medpar/TP1/Planificacion/Words/G1_PLANIFICACIÓN_ SEGUIMIENTO_CALIDAD.docx

# Plan de Trabajo del G1 TP1: Sistemas Electrónicos

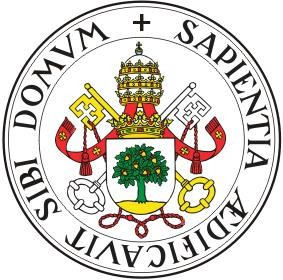
[picture p5: figure]

ESCUELA TÉCNICA SUPERIOR DE INGENIEROS DE TELECOMUNICACIÓN

UNIVERSIDAD DE VALLADOLID MÁSTER EN INGENIERÍA DE TELECOMUNICACIÓN TALLER DE PROYECTOS 1: SISTEMAS ELECTRÓNICOS

BARRIGON GOMEZ, MIGUEL MEDRANO PAREDES, MARIO RUIZ DE LAS HERAS, CLARA SANCHEZ VALENCIA, VICTOR

Semana | Actividad | Horas
1 | Especificación del proyecto Definición de objetivos | 4
2 | Especificación del proyecto Estudio sistema | 1
3 | Diseño electrónico y captura esquemática Búsqueda de componentes Posicionado componentes Creación de nuevos componentes Documentación esquemático. Control de cambios Análisis consumo eléctrico Análisis disipación de potencia Rutado de conexiones Generación de listado de materiales (BOM) | 7
4 | Diseño electrónico y captura esquemática Búsqueda de componentes Posicionado componentes Creación de nuevos componentes Documentación esquemático. Control de cambios Análisis consumo eléctrico Análisis disipación de potencia Rutado de conexiones Generación de listado de materiales (BOM) | 9,5
5 | Diseño de la placa de circuito impreso Creación de huellas de nuevos componentes Posicionado de componentes Definición de borde y zonas de conectores Rutado de conexiones Planos de disipación térmica Planos de masa y otros Documentación: serigrafía. Control de cambios Documentación: acotaciones geométricas Generación de ficheros para el fabricante (gerber) | 7,5
6 | Diseño de la placa de circuito impreso Creación de huellas de nuevos componentes Posicionado de componentes Definición de borde y zonas de conectores Rutado de conexiones Planos de disipación térmica Planos de masa y otros Documentación: serigrafía. Control de cambios Documentación: acotaciones geométricas Generación de ficheros para el fabricante (gerber) | 4
7 | Fabricación de la placa de circuito impreso Envío al fabricante Recepción y revisión Montaje de componentes | 4
8 | Fabricación de la placa de circuito impreso Envío al fabricante Recepción y revisión Montaje de componentes | 2

9 | Realización Firmware (uC/FPGA). Simulación y depuración Control de elementos hardware: drivers Verificación Programa principal. Especificaciones Documentación firmware. Control de cambios | 9
10 | Realización Firmware (uC/FPGA). Simulación y depuración Control de elementos hardware: drivers Verificación Programa principal. Especificaciones Documentación firmware. Control de cambios | 4
11 | Verificación hardware Verificación inicial Verificación firmware Resolución de problemas Análisis de prestaciones Montaje final. Piezas mecánicas | 4
12 | Verificación hardware Verificación inicial Verificación firmware Resolución de problemas Análisis de prestaciones Montaje final. Piezas mecánicas | 4
13 | | 7
14 | | 18
15 | Documentación Realización informe
| TOTAL

Diario

Semana 15/9-19/9

(Planificación: Definición de objetivos)

Durante esta semana se ha iniciado la asignatura de TP1-SE el martes 16 con una clase de 2h en la que se ha explicado la idea del proyecto, los contenidos de la asignatura y la forma de trabajo, además de todas las herramientas que se van a emplear. En la segunda sesión del día 19 de septiembre (1h) se ha terminado la introducción al proyecto con diferentes métodos de gestión de este. En esta sesión se han establecido los grupos de trabajo y se ha comenzado con la estimación temporal del proyecto con el método Gantt que se adjunta (1h).

Semana 22/9-26/9

(Planificación: Especificaciones del sistema)

El martes tuvimos 1h de clase donde conocimos las especificaciones hardware y como usar proteus, además de una hora donde Mario y Miguel empezaron con los diseños de las PBC’s y Victor y Clara terminaron el diagrama Gantt (1h). El miércoles por la tarde Miguel dedicó tiempo extra en la realización de los esquemáticos del PCB2 (2h). En la clase del viernes continuamos con el desarrollo de los diseños de los esquemáticos de las PBC’s (2.5h). En esta sesión se finalizaron los esquemáticos de las PCB1, PCB2 y PCB3, desarrollados por Mario, Miguel y Victor respectivamente. Clara comenzó el desarrollo de los esquemáticos correspondientes al PBC0.

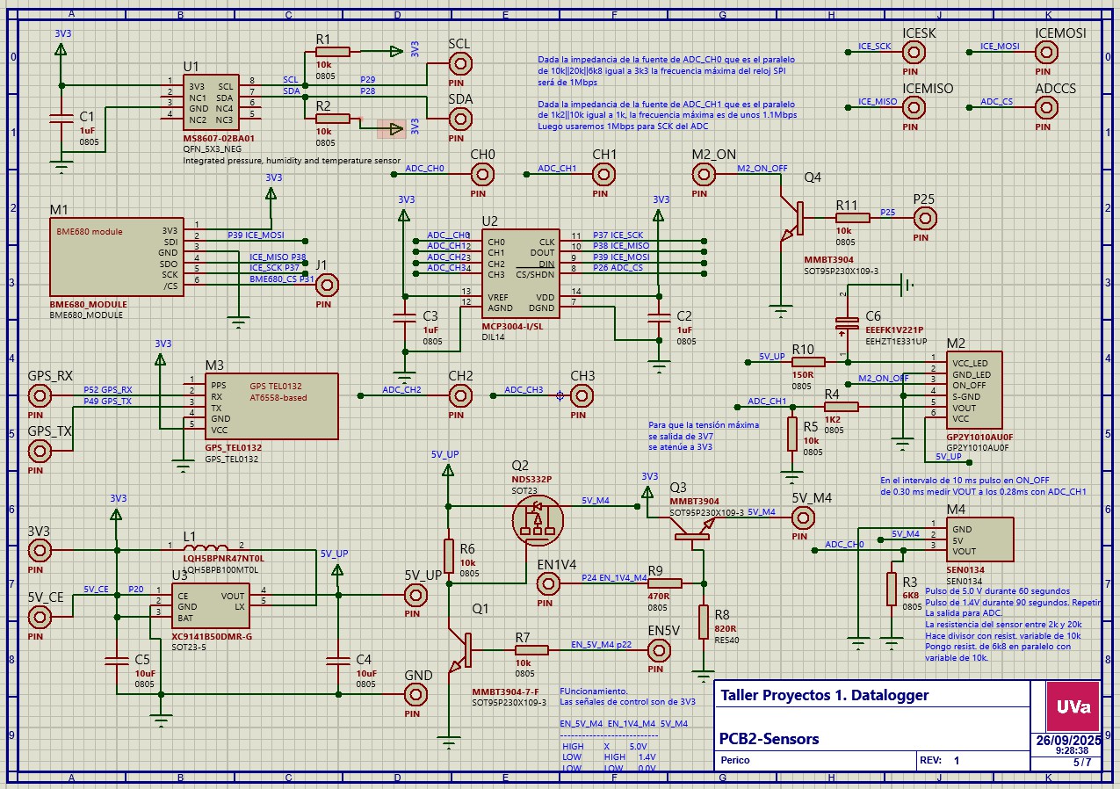
[picture p6: figure]

Figura 1. PCB2 Hoja raíz 1

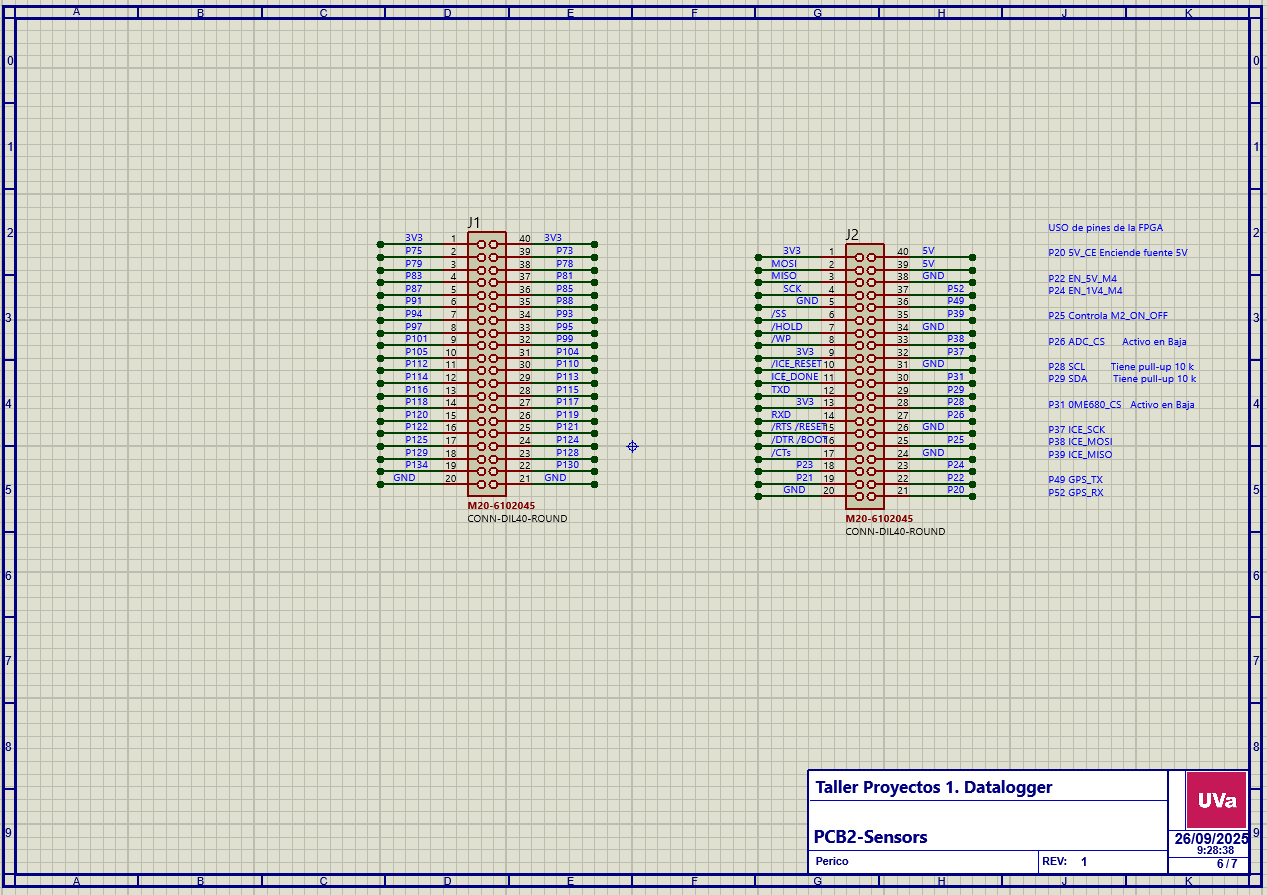
[picture p7: figure]

Figura 2. PCB2 Hoja raíz 2

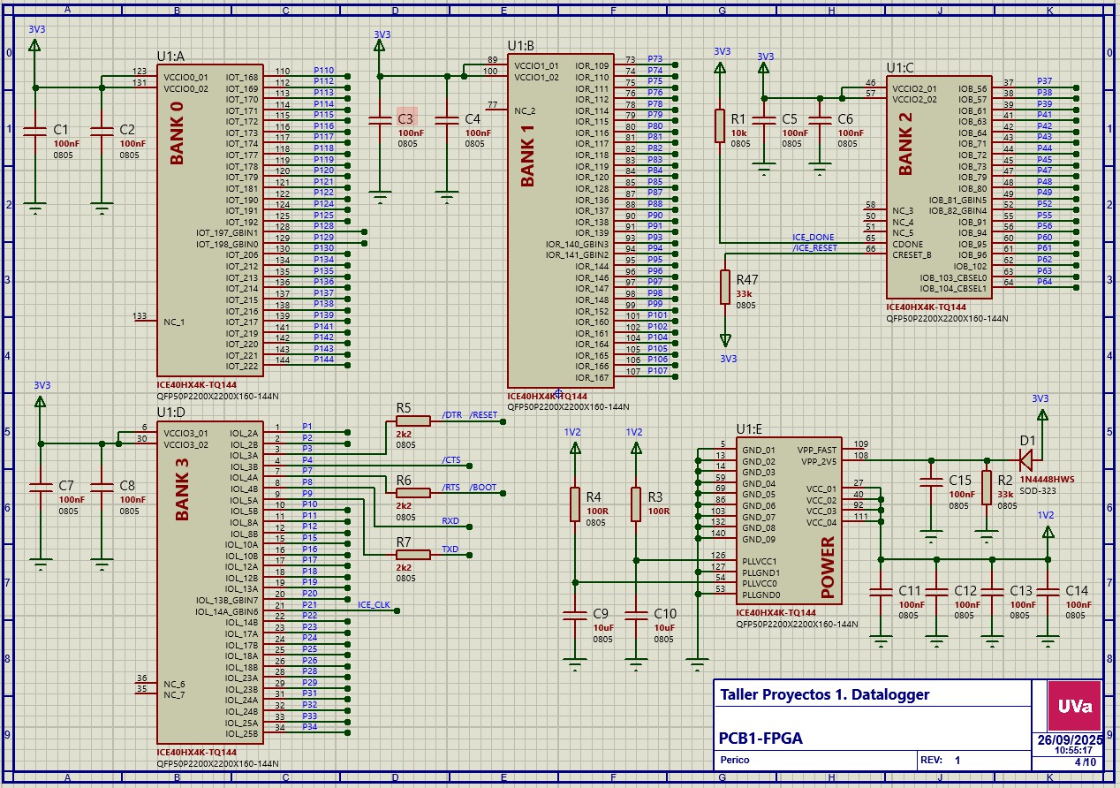
[picture p8: figure]

Figura 3. PCB1 Hoja raíz 1

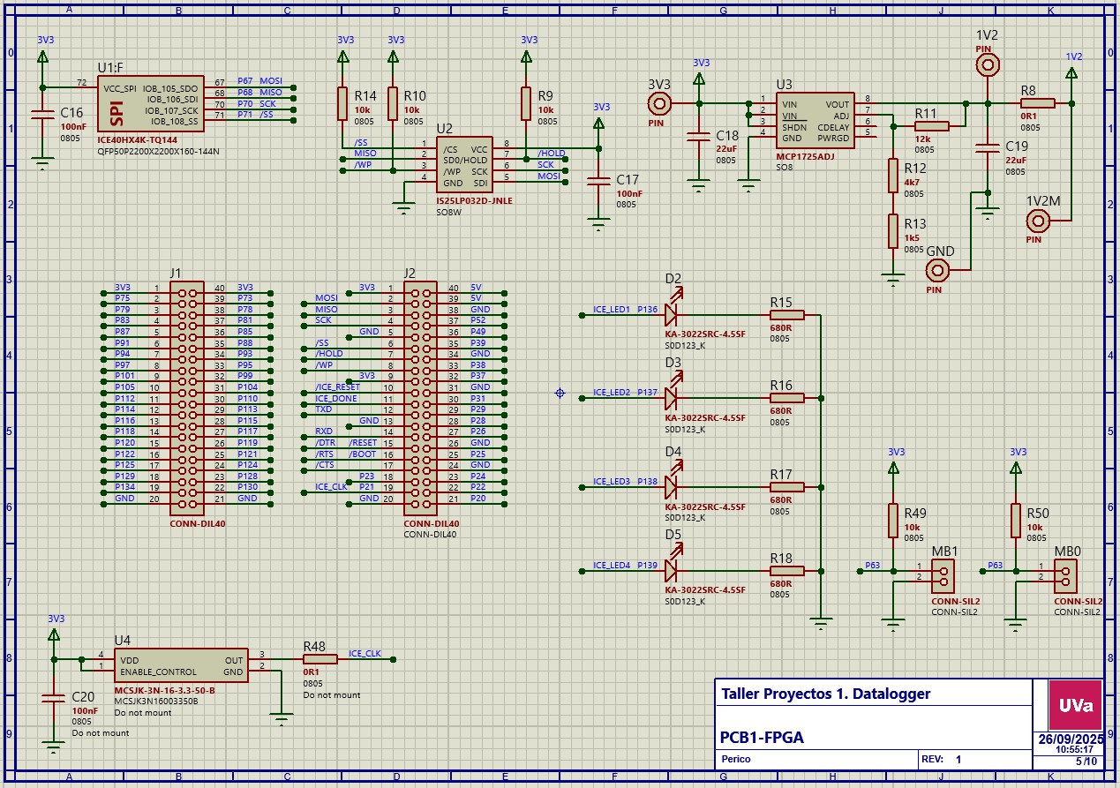
[picture p9: figure]

Figura 4. PCB1 Hoja raíz 2

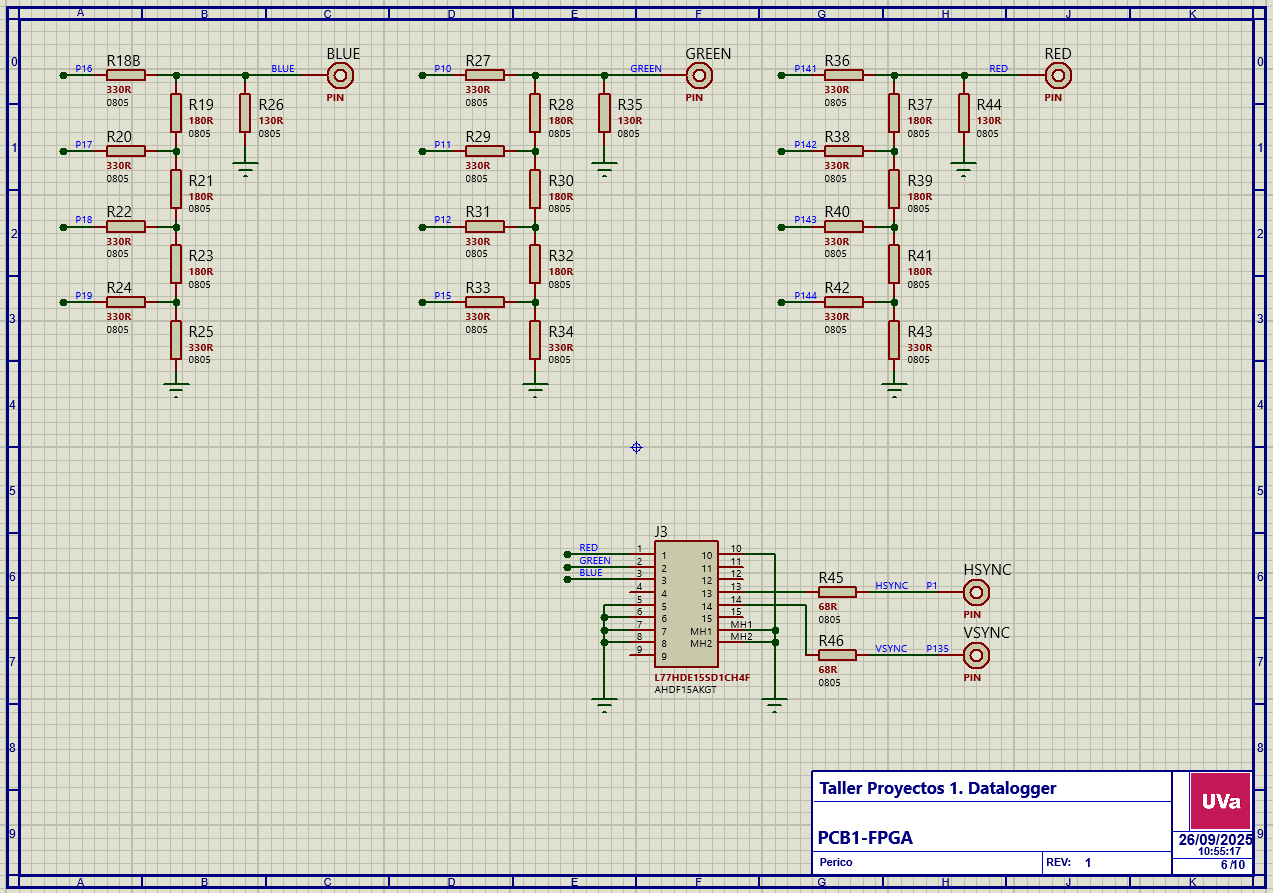
[picture p10: figure]

Figura 5. PCB1 Hoja raíz 3

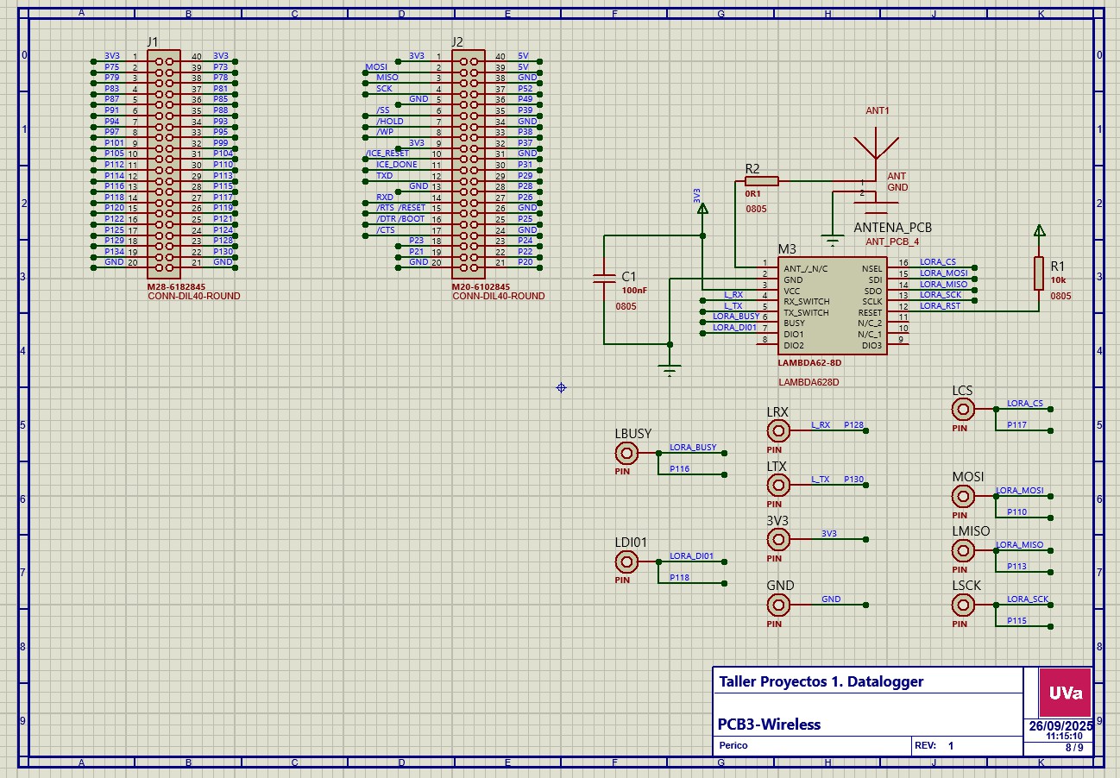
[picture p11: figure]

Figura 5. PCB1 Hoja raíz 3

Semana 29/9-3/10

(Planificación: Cálculo de costes y diseño de las PCBs)

En la sesión del martes se han realizado labores de actualización y refinado de los esquemáticos. Mario y Miguel comenzaron con la especificación de las PCBs mientras que Víctor y Clara se encargaban de comenzar con las hojas de coste y actualización de los diagramas Gant(1h). Clara dedico tiempo el jueves por la tarde para crear el logo y pensar en un nombre para nuestro grupo (2h).

En la sesión del viernes se continuo con las labores empezadas el martes dejando prácticamente acabadas las PCBs(dos de ellas no se van a poder mostrar por problemas para poder acceder a ellas al no haberse guardado correctamente) (2h).

Los esquemáticos se van a guardar en el Anexo 1 para así aligerar el peso de este archivo, y lo mismo se va a hacer con las PCBs en el Anexo 2. Se han introducido las imágenes actuales, cuando se realicen cambios las imágenes serán actualizadas.

Durante el fin de semana Víctor estuvo corrigiendo algunos de los comentarios del profesor durante la sesión. En concreto lo relativo a los ficheros BOM (que se encuentra en la carpeta BOM), además añadió el fichero final donde se detallará el proyecto en su conjunto, (1,5h).

Semana 06/9-12/10

(Planificación: análisis del consumo eléctrico)

El lunes tuvimos de nuevo una sesión de laboratorio, donde se enseñó como crear las huellas de los componentes y analizar el consumo eléctrico (1H). Además, continuamos realizando las huellas que se nos habían extraviado, actualizando el diagrama de Gantt y terminando con el Bill of Material (1 H).

Víctor actualizó el esquemático de la PCB3 debido a que íbamos a implementar una nueva antena con posibilidad de adaptación de impedancias con una red en forma de PI. Además, actualizó el BOM de la PCB3 con los nuevos componentes (0,5H).

El martes, Miguel y Mario continuaron con las PCBs. Se diseñaron y crearon las huellas faltantes y se finalizó el posicionamiento de todas las huellas para las cuatro placas de circuito impreso. Se diseñó la antena y se realizaron los cambios correspondientes en su esquemático. Víctor y Clara continuaron con la planificación, la documentación, el BOM y comenzaron a elaborar el análisis térmico y eléctrico.

Semana 13/10-19/10

(Planificación: análisis del consumo eléctrico)

El lunes tuvimos sesión de laboratorio, donde la primera sesión estuvimos aprendiendo sobre la PCB2 de sensores, su funcionamiento general, patillaje, consumos, o señales de calibración (1h). En la segunda parte de la sesión, Mario y Miguel finalizaron con las PCB que presentaron problemas anteriormente, mientras Víctor y Clara estuvieron con el análisis eléctrico de las PCB 0 y 1, además de con la actualización de la documentación, planificación y control de cambios (1H)

El miércoles, Miguel, finalizó las PCB’s 2 y 3, además de hacer el rutado de conexiones de estas PCB (2h)

Durante la sesión del viernes en el laboratorio se nos indicó cambios que debíamos hacer sobre los esquemáticos y las PCB, y nos pusimos a realizar estos cambios. Actualizamos la documentación, se finalizaron las PCBs 0 y 1 y sus rutados de conexiones. También continuamos con el análisis eléctrico. (2h)

El domingo Víctor finalizó el análisis eléctrico de la PCB 1 Y 3 (1h).

Semana 20/10-26/10

(Planificación: análisis del consumo eléctrico)

El lunes Víctor comenzó a redactar el inicio de la sección de planificación (0,5 h).

El martes Víctor y Clara trabajaron en el análisis eléctrico y térmico de los componentes durante las 2 horas, finalizando el análisis eléctrico e iniciando el análisis térmico de la PCB 0. Mientras, Miguel trabajó en el modelado de la antena de la PCB3 mientras que Mario finalizaba el rutado de la PCB1. Además ambos corrigieron los errores señalados por el profesor, referentes al diseño de las PCBs.

El jueves Víctor finalizó la corrección de los ficheros BOM según las instrucciones del profesor (2h), pasando la información de los pdf a los BOM. Además Clara trabajó el análisis térmico de los componentes, finalizando el análisis térmico de las 4 PCBs (1h).

El viernes Miguel finalizó el modelado de la antena de la PCB3. Además Mario y Miguel finalizaron la elaboración de los ficheros gerber y en general de todos los ficheros asociados a la elaboración de los esquemáticos de las PCBs.

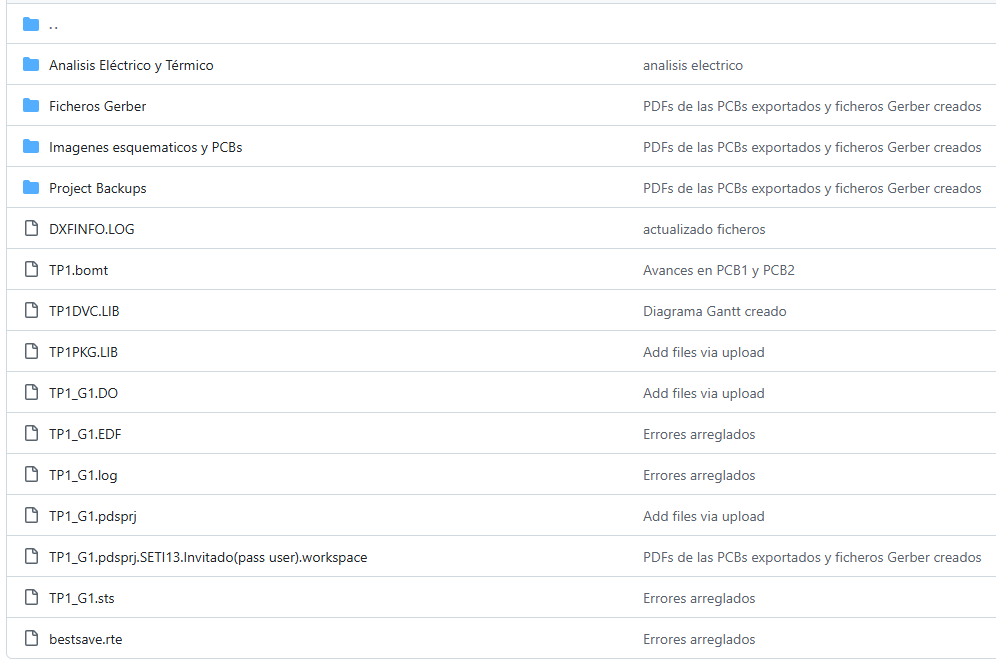
[picture p12: figure]

Semana 27/10-01/11

En esta semana se ha trabajado solo durante las dos horas de clase. Clara inicio el

trabajo de la presentación. Víctor empezó el informe final. Mario y Miguel corrigieron un

error de la PCB 3 relacionado con la antena, se "cosió" esa misma PCB y se corrigieron

los tamaños de las pistas de alimentación de las distintas PCBs

Semana 3/11-9/11

El martes, todos los integrantes del grupo realizaron la documentación y el estudio inicial para los contenidos de la presentación oral. El viernes, se prepararon las transparencias colaborativas y se incluyeron imágenes y diagramas representativos.

Además, se corrigieron errores menores en el diseño, se exportaron los PDFs con todas las PCBs, y se modeló la antena a fabricar en el programa de simulación electromagnética Ansys HFSS.

Semana 10/11-16/11

Durante esta semana todos los miembros del equipo tuvieron exámenes de otras asignaturas de manera que no tuvieron tiempo para continuar con las presentaciones o el envío al fabricante.

Semana 17/11-23/11

El martes antes de acudir a nuestra cita en el FABLAB, hicimos una revisión de la presentación que debíamos realizar para darnos cuenta que había algunas partes de esa presentación que no estaban completas. Llegada la hora fuimos a la visita de FABLAB donde nos enseñaron las herramientas de impresión 3D, escaner 3D, cortadora laser, … También asistimos a una lluvia de ideas para dar una solución con las herramientas vistas de un problema real. Expusimos ante los compañeros dichas ideas y regresamos al aula. (2h)

El viernes tuvimos una nueva sesión de laboratorio donde se revisaron las placas de antena para poder hacer el pedido a la fabricación. Se realizó el pedido a fabricación de la PCB3.

También se actualizó el diagrama Gannt,

(2h)

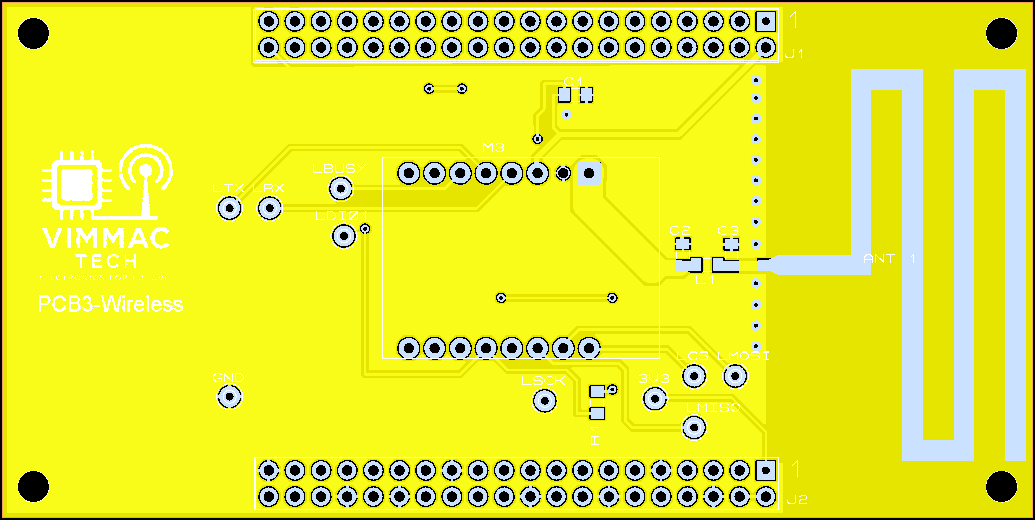
[picture p13: figure]
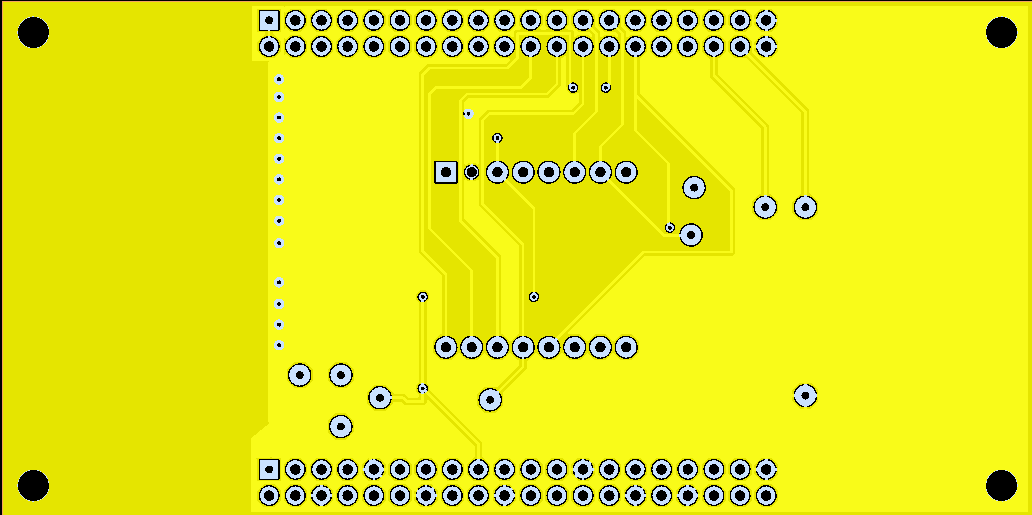
[picture p14: figure]

Semana 24/11-30/11

Durante la sesión del martes dedicamos la primera hora y media a grabar el vídeo de YouTube para el cual durante los días anteriores preparamos la presentación. Cada uno de nosotros presentó la parte que se había preparado tanto en inglés como en español. La última media hora nos sirvió para familiarizarnos con el laboratorio donde se montarán las PCB ya que el profesor nos dio una charla informativa sobre los protocolos de seguridad en este laboratorio.

Durante la sesión del viernes recibimos una charla introductoria por el profesor, en la que se nos explicaron los principios básicos para soldar y montar PCBs. Se comenzó el montaje y durante la última media hora Clara y Miguel procedieron con la ejecución de LarVa, con el objetivo de observar los datos enviados en el osciloscopio.

Como observaciones hay que aclarar que la PCB3 ya se ha fabricado y que a día 28 se encuentra en envío.

Semana 01/12-07/12

En esta semana ambas sesiones se han estructurado de manera similar, en ellas nos hemos dividido en grupos de dos, Víctor y Mario, Miguel y Clara. Durante las sesiones, Víctor y Mario se han dedicado a soldar componentes a una de las PCBs, mientras que Clara y Miguel se han dedicado a la parte relacionada con LarVa, modificando los direccionamientos de memoria y aumentado esta.

Semana 08/12-14/12

A lo largo de la sesión del martes, Víctor y Mario finalizaron el soldado y montaje de las dos placas de circuito impreso. Tras acabar, se comprobó el hardware para verificar que todos los componentes funcionasen correctamente. Miguel y Clara siguieron con la programación de LarVa.

Durante la sesión del viernes, Víctor y Mario continuaron con la memoria final, la documentación y la organización general del proyecto. Miguel y Clara continuaron con el desarrollo y el testeo del software.

Semana 15/12-21/12

En la sesión del martes Clara y Miguel han continuado con las UARTs y el SPI necesarias para la comunicación con los diferentes periféricos, han comprobado que funcionasen y estuvieran bien. Mario y Victor han continuado con la memoria y han empezado con la programación en C para poder leer los datos que manden cada sensor. (2h)

El jueves Miguel y Clara estuvieron en el laboratorio continuando con la programación de las UARTs y el PCIO (3h)

En la clase de jueves (muy navideña) hemos continuado arreglando los problemas de las UARTS, Victor por su parte ha estado con la decodificación de las señales GPS, y ya ha conseguido que funcione. (2h)

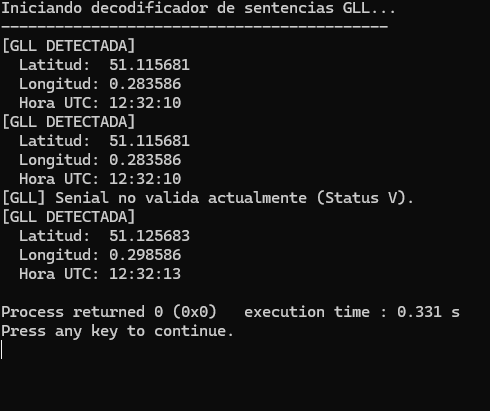
[picture p15: figure]

Semana 12/01-18/01

Durante la clase del lunes se trabajó repasando los avances realizados en el proyecto, así como repartiendo las tareas restantes entre los 4 miembros del grupo (2h). Además, por la tarde Mario trabajó en la programación de los sensores necesarios para el proyecto (3h).

Durante la tarde del martes Miguel y Clara estuvieron trabajando en la programación de las UARTS y SPI. Tras varias pruebas finalmente se detectó un fallo en una de las PCBs (4h).

El miércoles Miguel, Víctor y Clara trabajaron brevemente comprobando el funcionamiento del Datalogger una vez sustituidas las placas problemáticas por unas nuevas (3h).

El jueves Miguel trabajó por la tarde ajustando variables en el problema general y creando el script del módulo LoRa(4h).

Durante la clase del viernes continuamos con la integración de los sensores y el módulo LoRa en el programa(2h).

Plan de Trabajo del G1 de TP1: Sistemas Electrónicos
