medpar/TP1/Planificacion/Words/VIMMAC_TECH_G1_DOCUMENTACIÓN.docx

PROYECTO DATALOGGER


ESCUELA TÉCNICA SUPERIOR DE INGENIEROS DE TELECOMUNICACIÓN

UNIVERSIDAD DE VALLADOLID

MÁSTER EN INGENIERÍA DE TELECOMUNICACIÓN

TALLER DE PROYECTOS 1: SISTEMAS ELECTRÓNICOS

BARRIGON GOMEZ, MIGUEL

MEDRANO PAREDES, MARIO

RUIZ DE LAS HERAS, CLARA

SANCHEZ VALENCIA, VICTOR

RESUMEN

# 1. Introducción

# 2. Planificación

## 2.1 Diagramas de Gantt

# 3. Hardware

## 3.1 Esquemas Electrónicos

ANEXO 1

# ANEXO 1: ESQUEMATICOS

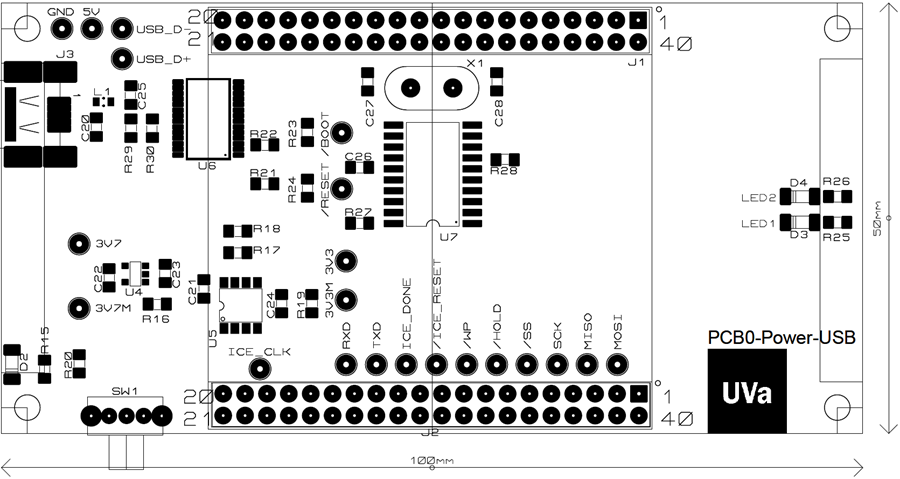
[picture p18: figure]

# ANEXO 2: PCB

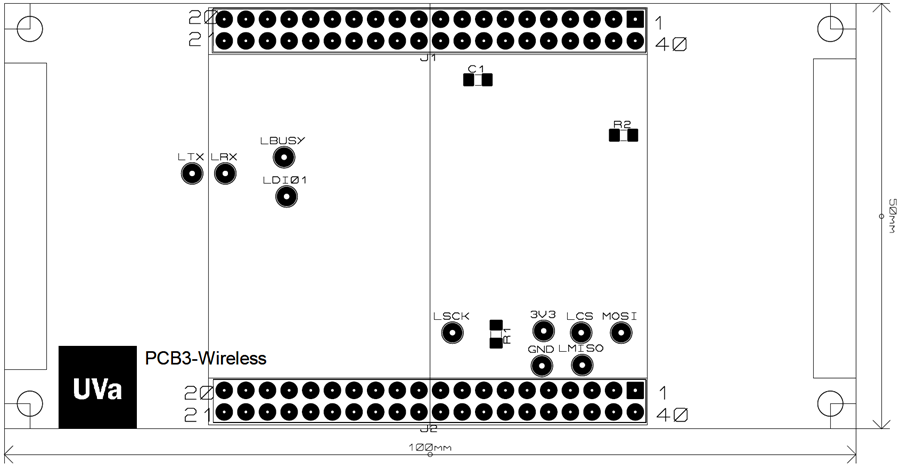
[picture p19: figure]

# ANEXO 3: Bill Of Materials

VIMMAC TECHProyecto Datalogger1
