medpar/TP1/Hardware/Analisis Eléctrico y Térmico/Analisiselectrico-C.xlsx

Sheet: TOTAL_V
ANALISIS ELECTRICO |  |  | ANALISIS TÉRMICO
P_3,3V | 4.5224743 | W | t_3,3V | 141.5148182 | ºc
P_5V | 0.10759 | W | t_5V | 1.73058 | ºc
P_2,6V | 0.052 | W | t_2,6V | 13 | ºc
P_3,7V | 0 | W | t_3,7V | 0 | ºc
P_1,2V | 2.52e-05 | W | t_1,2V | 0.00096516 | ºc
TOTAL | 4.6820895 | W | TOTAL | 156.2463633 | ºc

Sheet: PCB0.Alim_Prog_USB
Power Calculations |  |  |  |  | Thermal Analysis
Components | Conditions | Voltage (V) | Currents (µA) | Power (W) | Components | Conditions | Power | Max Power | Theta_jar(Cº/W) | Temperature (Cº)
MCP73831T-2QACI/OT | Charging | 5 | 1500 | 0.0075 | MCP73831T-2QACI/OT | Charging | 0.0075 |  | 230 | 1.725
 |  |  |  |  |  | 4-Layer JC51-7 Standard Board, Natural Convection |  |  |  | 0
MCP1725-ADJ E/SN | IL = 0 mA, VIN = Note 1 VOUT = 0.8V to 5.0V | 3.3 | 5000 | 0.85 | MCP1725-ADJ E/SN | IL = 0 mA, VIN = Note 1 VOUT = 0.8V to 5.0V | 0.85 |  | 163 | 138.55
CY765213-28PVXI | USB 2.0 FS, UART at 1-Mbps single channel, no GPIO switching at VCC = 5 V, VCCIO = 5 V | 5 | 18 | 9e-05 | CY765213-28PVXI | USB 2.0 FS, UART at 1-Mbps single channel, no GPIO switching at VCC = 5 V, VCCIO = 5 V | 9e-05 |  | 62 | 0.00558
LPC1112FD20/102 | Per supply pin | 3.3 | 3000 | 0.0099 | LPC1112FD20/102 | Per supply pin | 0.0099 |  | 115.2 | 1.14048
 |  | P_5V | 0.00759 | W |  |  |  | P_5V | 1.73058 | ºc
 |  | P_3,3V | 0.8599 | W |  |  |  | P_3,3V | 139.69048 | ºc
 |  | P_2,6V | 0 | W |  |  |  | P_2,6V | 0 | ºc
 |  | P_3,7V | 0 | W |  |  |  | P_3,7V | 0 | ºc
 |  | TOTAL | 0.86749 | W |  |  |  | TOTAL | 141.42106 | ºc
 |  |  | 867.49 | mW
Note 1: VIN ≥ 2.3V, VIN ≥ VOUT(MAX) + VDROPOUT(MAX), VIN ≥ 2.3V, VIN ≥ VOUT(MAX) + VDROPOUT(MAX)

Sheet: PCB1.FPGA
Power Calculations |  |  |  |  | Thermal Analysis
Components | Conditions | Voltage (V) | Currents (A) | Power (W) | Components | Conditions | Power | Max Power | Theta_jar(°C/W) | Temperature (Cº)
ICE40HX4K-TQ144 | standby power | 3.3 | 2.1e-05 | 6.93e-05 | ICE40HX4K-TQ144 | standby power | 6.93e-05 |  | 38.3 | 0.00265419
ICE40HX4K-TQ144 | power | 1.2 | 2.1e-05 | 2.52e-05 | ICE40HX4K-TQ144 | power | 2.52e-05 |  | 38.3 | 0.00096516
1N4448HSW-7-F |  | 3.3 | 1e-05 | 3.3e-05 | 1N4448HSW-7-F |  | 3.3e-05 |  | 222 | 0.007326
IS25LP032D-JNLE | FRD Quad at 133MHz | 3.3 | 0.017 | 0.0561 | IS25LP032D-JNLE | FRD Quad at 133MHz | 0.0561 |  |  | 0
MCP1725-ADJ E/SN | IL = 0 mA, VIN = Note 1, VOUT = 0.8V to 5.0V | 3.3 | 0.00022 | 0.000726 | MCP1725-ADJ E/SN | IL = 0 mA, VIN = Note 1, VOUT = 0.8V to 5.0V | 0.000726 |  | 163 | 0.118338
M20-6102045 |  | 0 | 0 | 0 | M20-6102045 |  | 0 |  |  | 0
109296002381906 |  | 0 | 0 | 0 | 109296002381906 |  | 0 |  |  | 0
MCSJK-3N-16.00-3.3-50-B | Supply Current | 3.3 | 0.015 | 0.0495 | MCSJK-3N-16.00-3.3-50-B | Supply Current | 0.0495 |  |  | 0
HSMS-C170 |  | 2.6 | 0.02 | 0.052 | HSMS-C170 |  | 0.052 |  | 250 | 13
L77HDE15SD1CH4F |  | 0 | 0 | 0 | L77HDE15SD1CH4F |  | 0
 | P_3,3V | 0.1064283 | W |  |  |  |  | P_5V | 0 | ºC
 | P_1,2V | 2.52e-05 | W |  |  |  |  | P_3,3V | 0.12831819 | ºC
 | P_2,6V | 0.052 | W |  |  |  |  | P_2,6V | 13 | ºC
 |  |  |  |  |  |  |  | P_3,7V | 0 | ºC
 | TOTAL | 0.1584535 | W |  |  |  |  | P_1,2V | 0.00096516 | ºC
 |  | 158.4535 | mW
 |  |  |  |  |  |  |  | TOTAL | 13.12928335 | ºC

Sheet: PCB2.Sensores
Power Calculations |  |  |  |  | Thermal Analysis
Components | Conditions | Voltage (V) | Currents (mA) | Power (W) | Components | Conditions | Power | Max Power | Theta_jar | Temperature (Cº)
TEL0132 |  | 3.3 | 25 | 0.0825 | TEL0132 |  | 0.0825
BME680 |  | 3.3 | 12 | 0.0396 | BME680 |  | 0.0396
MS860702BA01-50 | 25°C, VDD = 3V | 3.3 | 240 | 0.792 | MS860702BA01-50 | 25°C, VDD = 3V | 0.792 |  |  | 1.5 | temperature increase over humidity sensor
GP2Y1010AU0F |  | 5 | 20 | 0.1 | GP2Y1010AU0F |  | 0.1
SEN0134 |  | 5 |  | 0 | SEN0134 |  | 0
MCP3004-I/SL | VDD = VREF = 5V, DOUT unloaded VDD = VREF = 2.7V, DOUT unloaded | 3.3 | 0.55 | 0.001815 | MCP3004-I/SL | VDD = VREF = 5V, DOUT unloaded VDD = VREF = 2.7V, DOUT unloaded | 0.001815 |  | 108 | 0.19602
XC9141B50DMR-G |  | 3.3 | 800 | 2.64 | XC9141B50DMR-G |  | 2.64
 |  | P_3,3V | 3.555915 | W |  |  | P_5V | 0 | ºc
 |  | P_5V | 0.1 | W |  |  | P_3,3V | 1.69602 | ºc
 |  | P_2,6V | 0 | W |  |  | P_2,6V | 0 | ºc
 |  |  |  |  |  |  | P_3,7V | 0 | ºc
 |  | TOTAL | 3.655915 | W |  |  | P_1,2V | 0 | ºc
 |  |  | 3655.915 | mW
 |  |  |  |  |  |  | TOTAL | 1.69602 | ºc

Sheet: PCB3.Antena en PCB
Power Calculations |  |  |  |  |  | Thermal Analysis
Components | Conditions | Voltage (V) | Currents (µA) | Power (W) |  | Components | Conditions | Power | Max Power | Theta_jar | Temperature (Cº)
LAMBDA62-8D | Quiescent current | 3.3 | 7e-05 | 0.000231 |  | LAMBDA62-8D | Quiescent current | 0.000231
 |  |  | P_3,3V | 0.000231 | W
 |  |  | TOTAL | 0.000231 | W |  | P_3,3V | 0 | ºc
 |  |  |  | 0.231 | mW |  | TOTAL | 0 | ºc
