medpar/TP1/Planificacion/Words/gantt_final.png

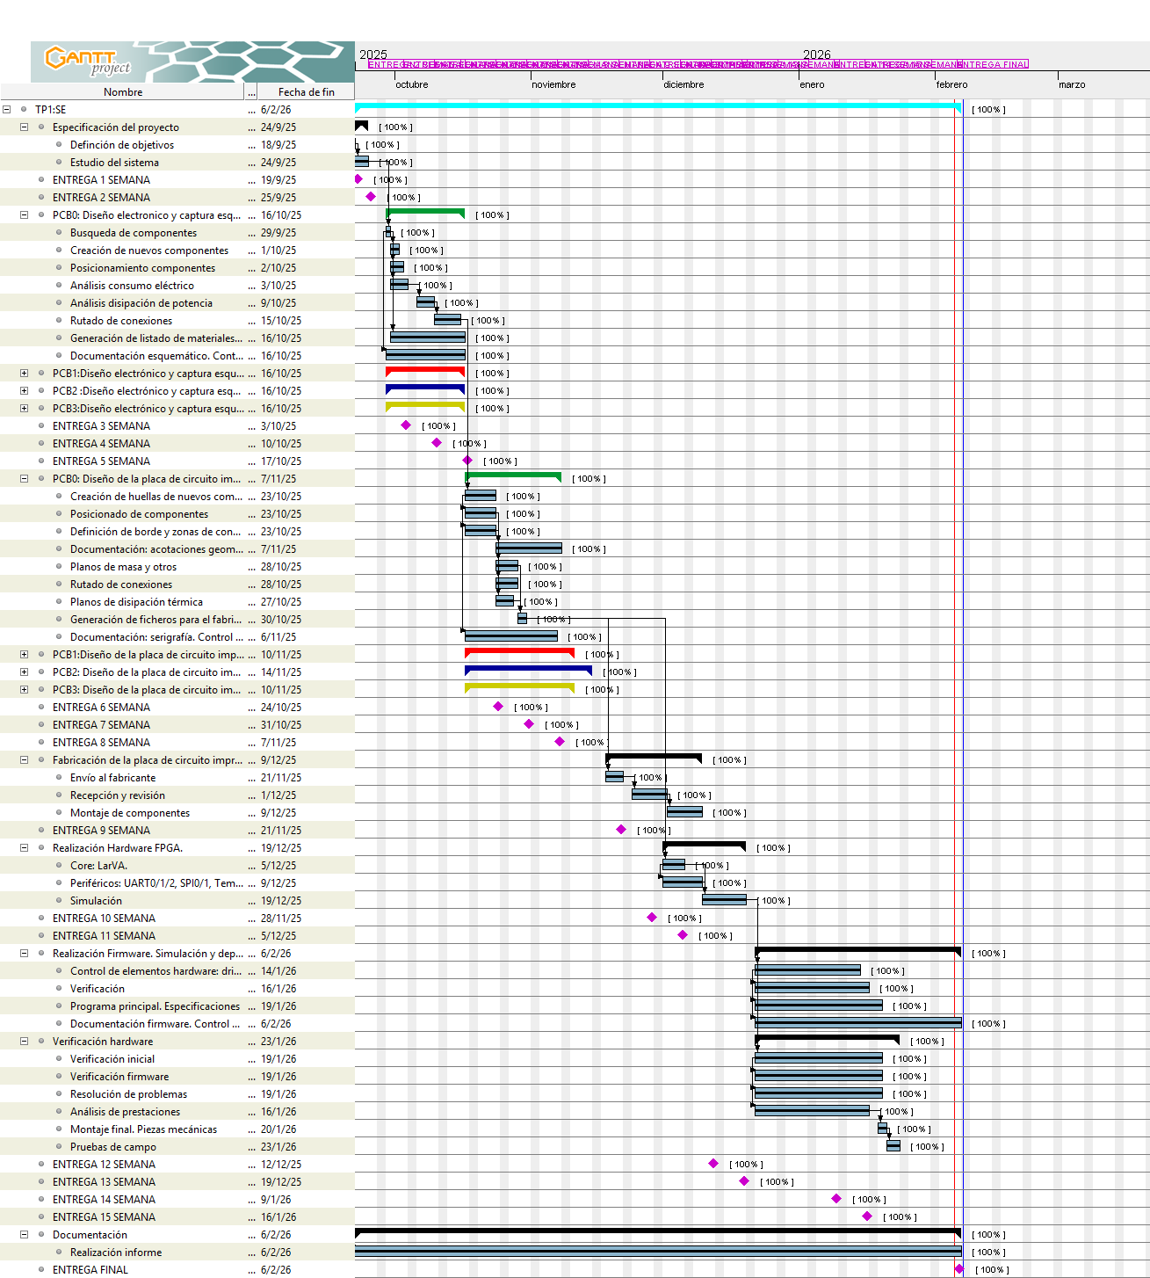
Planificacion/Words/gantt_final.png
