medpar/TP1/Planificacion/Words/TP1SEgantt.png

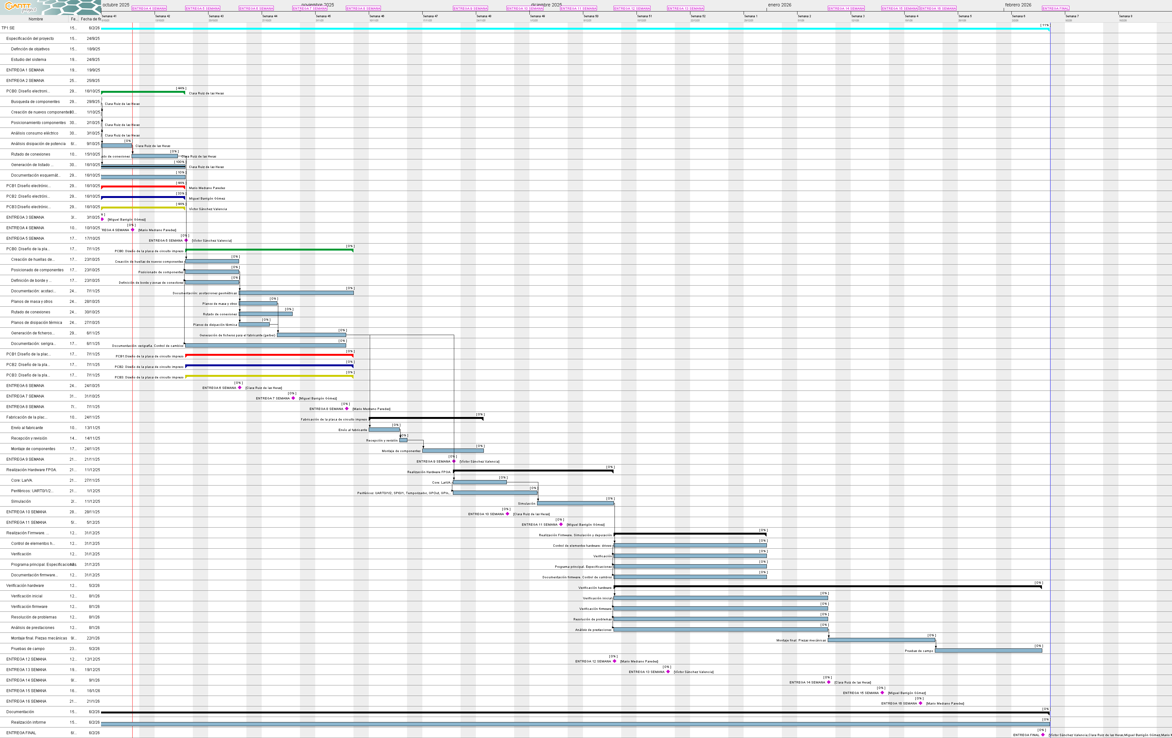
Planificacion/Words/TP1SEgantt.png
