medpar/TP1/Planificacion/Words/TP1SEPERT.png

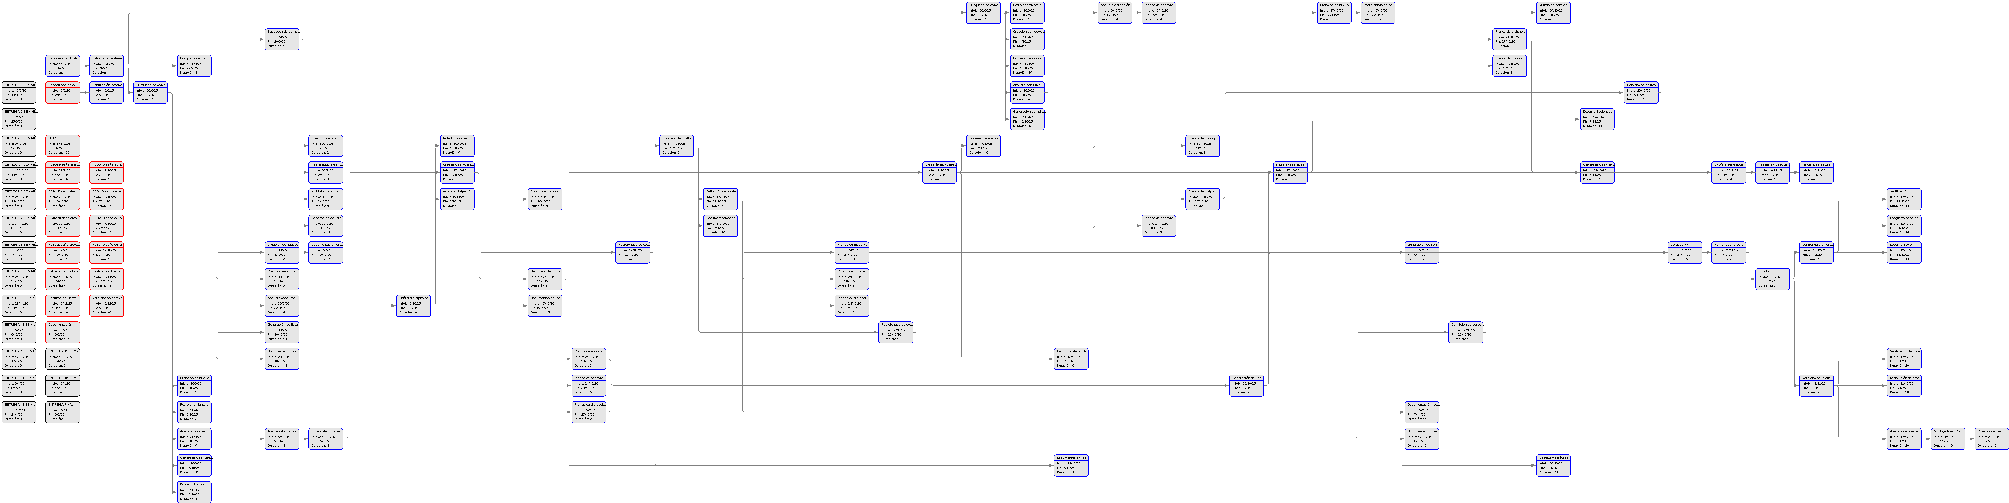
Planificacion/Words/TP1SEPERT.png
