medpar/TP1/Software/Captura de pantalla (2).png

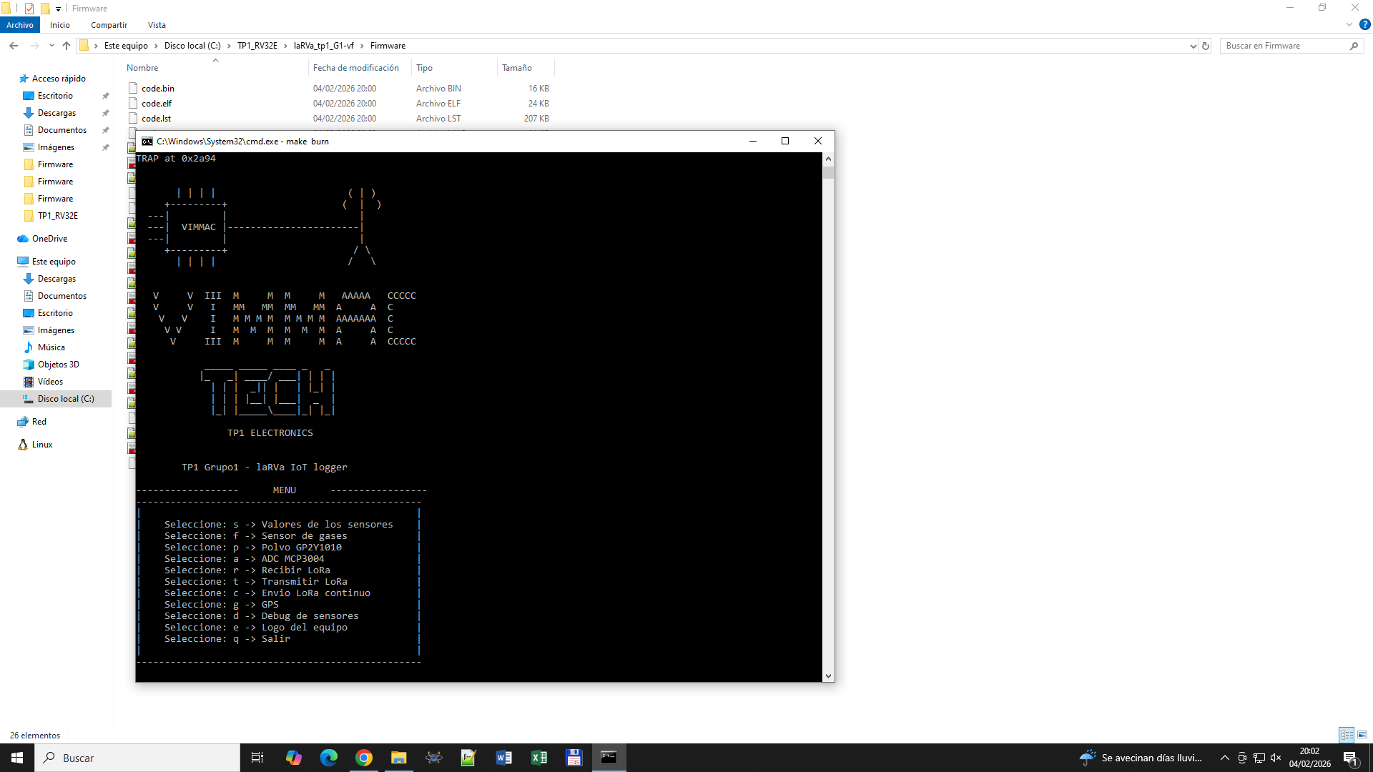
Software/Captura de pantalla (2).png
