medpar/TP1/Software/Captura de pantalla (8).png

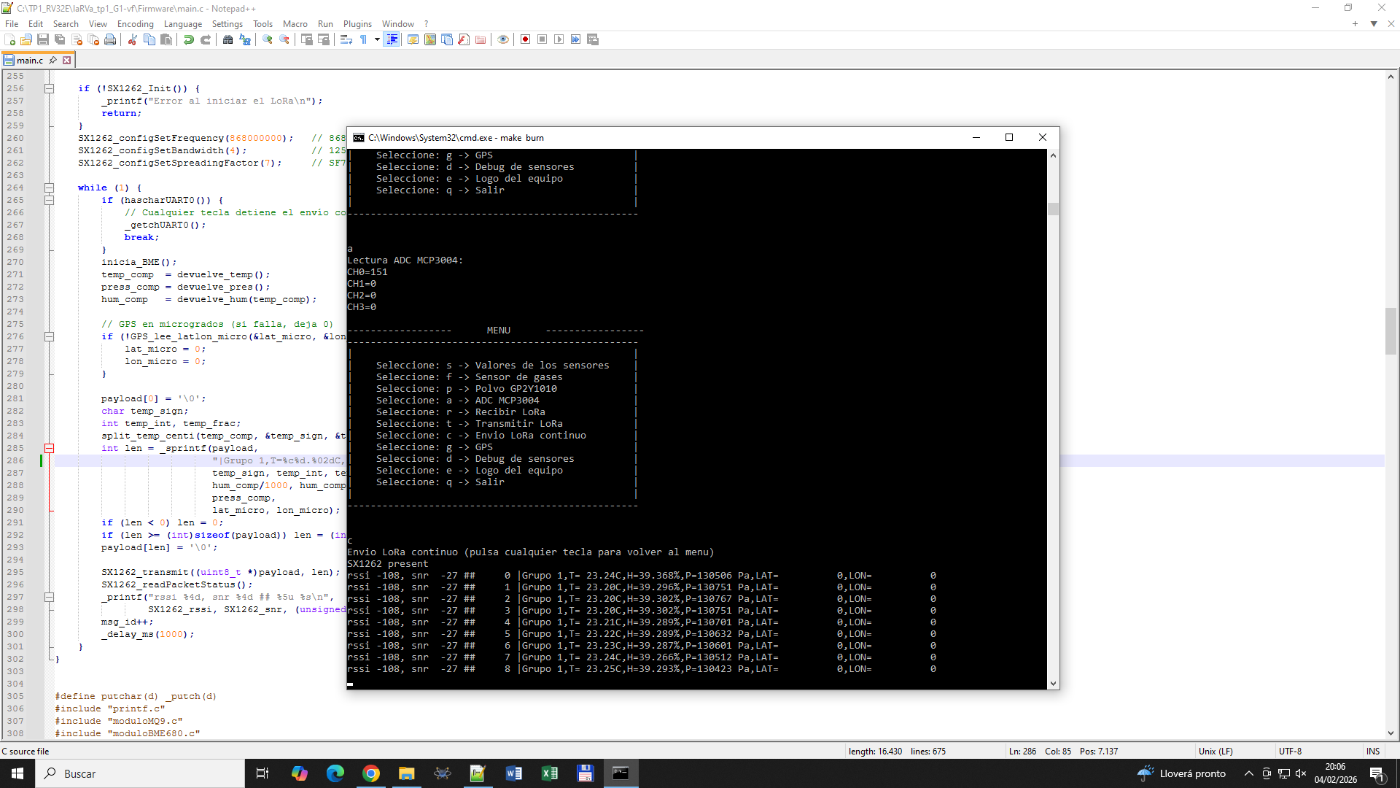
Software/Captura de pantalla (8).png
