medpar/TP1/Software/Captura de pantalla (9).png

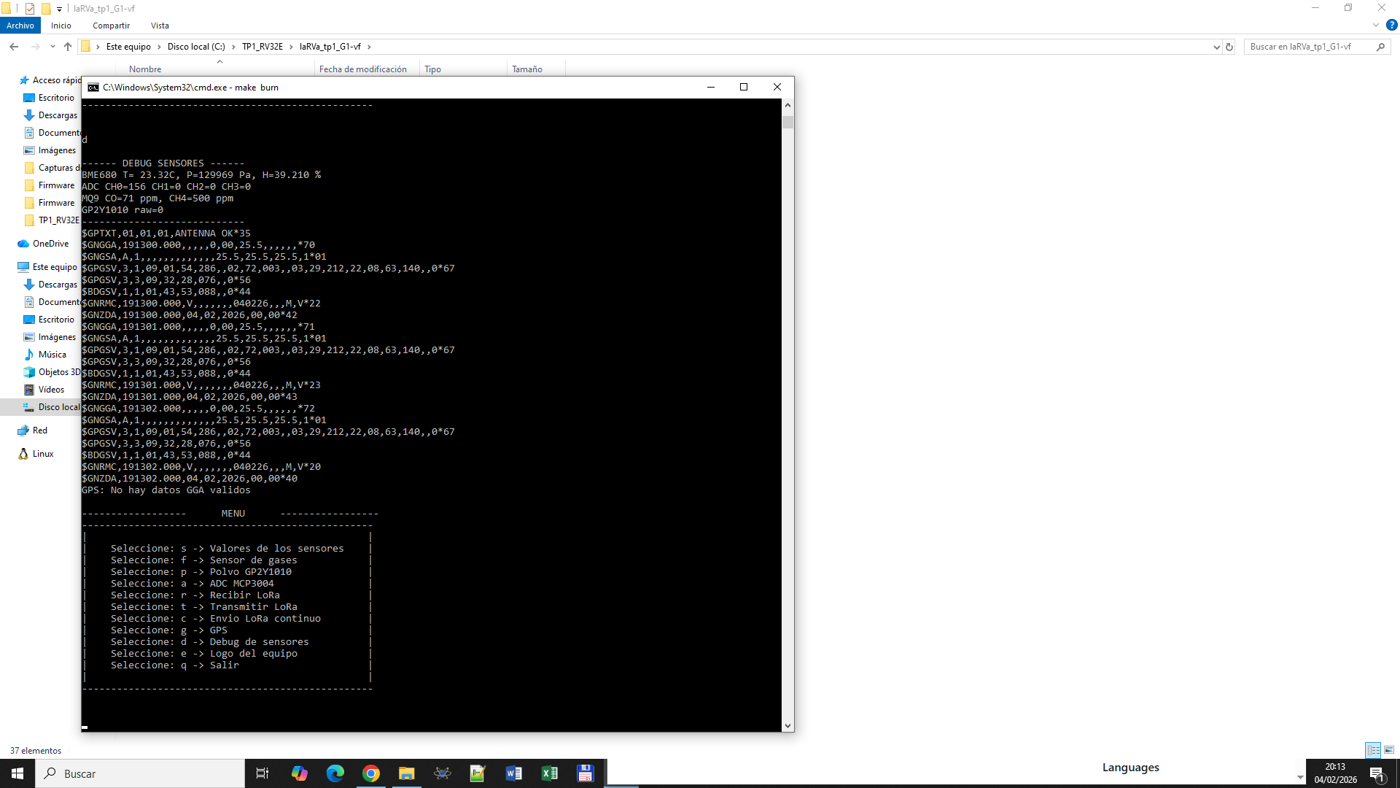
Software/Captura de pantalla (9).png
