medpar/TP1/Planificacion/BOM/BOM0.pdf

### Universidad de Valladolid Desarrollo Práctico de Sistemas Electrónicos

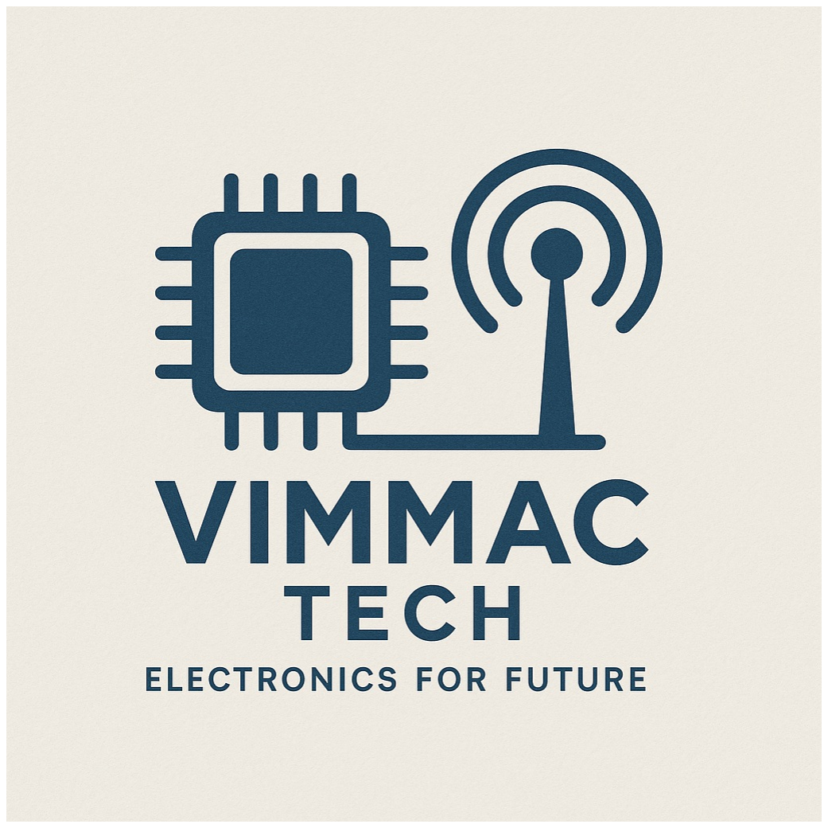
[picture p30: figure]

### Bill Of Materials for Taller Proyectos 1. Datalogger

Design Title | Taller Proyectos 1. Datalogger
Author | VIMMAC TECH
Document Number | 1
Revision | 3
Board | PCB0-Power-USB
Design Created | miércoles, 21 de septiembre de 2022
Design Last Modiied viernes, 24 de octubre de 2025 Total Parts In Design 61

Notes
Precios sin IVA (21%), VAT not added
No incluyen gastos de envio, shipping costs not included
Algunos valores corresponden con la compra de 10 uds o más, Some values correspond to the purchase of 10 units or more.

### 9 Capacitors

Quantity | References | Value | PCB Package | Farnell code
Cost
2 | C20,C26 | 100nF | 0805 | | 0,168€
4 | | C21,C22,C23,C24 | | 22uF | | 0805 | 0,29325€
1 | | C25 | | 10pF | | 0805 | 0,0255€
2 | | C27,C28 | | 18pF | | 0805 | 0,283€
Sub-totals: | 2,10€

### 16 Resistors

Quantity | References | Value | PCB Package | Farnell code
Cost
1 | R15 | 220R | 0805 | | 0,0216€
3 | | R16,R27,R28 | | 2k2 | | 0805 | 0,0173€
1 | | R17 | | 71K5 | | 0805 | 0,0364€
4 | | R18,R23,R24,R30 | | 10k | | 0805 | 0,175€
2 | R19,R20 | 0R1 | 0805 | | 0,0939€
2 | | R21,R22 | | 470R | | 0805 | 0,0407€
2 | R25,R26 | 680R | 0805 | | 0,033€
1 | | R29 | | 4K7 | | 0805 | 0,0381€
Sub-totals: | 1,18€

### 4 Integrated Circuits

Quantity | References | Value | PCB Package | Farnell code | Cost
1 | U4 | MCP73831T-2ACI/OT | SOT23-5 | 1332158 | 0,636€
1 | | U5 | | MCP1725-ADJ E/SN | | S08 | 1834878 | 0,655€
1 | U6 | CY7C65213-28PVXI | SSOP28 | 2767866 | 1,730€
1 | | U7 | | LPC1112FD20/102 | | SO20W | 2470837 | 2.56€
Sub-totals: | | | | | 5,58€

### 3 Diodes

Quantity | References | Value | PCB Package | Farnell code | Cost
2 | D2,D3 | HSMSC170 | SOD123_K | 5790839 | 0,179€

1 | D4 | KA-3022SGC-4.5SF | SOD123_K | 1142615 | 0,33€
Sub-totals: | | | | | 0,69€

### 29 Miscellaneous

Quantity | References | Value | PCB Package | Farnell code | Cost
21 | /BOOT,/HOLD,/ICE_RESET,/RESET,/SS,/WP,3V3,3V7, 3V3M,3V7M,5V,GND,ICE_CLK,ICE_DONE,MISO,MOSI, RXD,SCK,TXD,USB_D+,USB_D- | PIN | PIN | | 0€
1 | | BAT | | 530480310 | | 530480310 | 9732918 | 0,260€
1 | BAT5 | LP735977JH | NULL | 4551044 | 34,760€
2 | | J1,J2 | | 2214S-40SG-85 | | CONN-DIL40- | 2847248 | 1,86€
ROUND
1 | J3 | USB MINI B Molex 67503-1230 | MOLEX USB MINI B 67503-1230 | 2313554 | 1,140€
1 | | L1 | | MMZ1608B121C | | RESC1608X84 | 2800823 | 0,0484€
1 | | SW1 | | OS102011MA1QS1 | | OS102011MA1QS1 | 2435103 | 0,455€
1 | | X1 | | ABL-12.000MHZ-B2 | | HC-49S-TH | 2467707 | 0,235€
Sub-totals: | 40,62€
Totals: | 50,17€ viernes, 24 de octubre de 2025 0:42:28
