medpar/TP1/Planificacion/BOM/BOM1.pdf

### Universidad de Valladolid Desarrollo Práctico de Sistemas Electrónicos


### Bill Of Materials for Taller Proyectos 1. Datalogger

Design Title | Taller Proyectos 1. Datalogger
Author | VIMMAC TECH
Document Number | 1
Revision | 3
Board | PCB1-FPGA
Design Created | miércoles, 21 de septiembre de 2022
Design Last Modiied viernes, 24 de octubre de 2025 Total Parts In Design 94

Notes
Precios sin IVA (21%), VAT not added
No incluyen gastos de envio, shipping costs not included
Algunos valores corresponden con la compra de 10 uds o más, Some values correspond to the purchase of 10 units or more.

### 20 Capacitors

Quantity | References | Value | PCB Package | Farnell code
Cost
16 | C1,C2,C3,C4,C5,C6,C7,C8,C11,C12,C13, C14,C15,C16,C17,C20 | 100nF | 0805 | | 0,168€
2 | | C9,C10 | | 10uF | | 0805 | 0,0545 €
2 | | C18,C19 | | 22uF | | 0805 | 0,29325€
Sub-totals: | 3,38€

### 51 Resistors

Quantity | References | Value | PCB Package | Farnell code
Cost
6 | R1,R9,R10,R14,R49,R50 | 10k | 0805 | | 0,175€
2 | | R2,R47 | | 33k | | 0805 | 0,0564€
2 | R3,R4 | 100R | 0805 | | 0,0521€
3 | | R5,R6,R7 | | 2k2 | | 0805 | 0,0173€
2 | | R8,R48 | | 0R1 | | 0805 | 0,0939€
1 | | R11 | | 12k | | 0805 | 0,420€
1 | R12 | 4k7 | 0805 | | 0,0381€
1 | | R13 | | 1k5 | | 0805 | 0,420€
4 | R15,R16,R17,R18 | 680R | 0805 | | 0,033€
9 | | R19,R21,R23,R28,R30,R32,R37,R39,R41 | | 180R | | 0805 | 0,0753€
15 | R20,R22,R24,R25,R27,R29,R31,R33,R34, R36,R38,R40,R42,R43,R18B | 330R | 0805 | | 0,270€
3 | | R26,R35,R44 | | 130R | | 0805 | 0,0345€
2 | R45,R46 | 68R | 0805 | | 0,0478€
Sub-totals: | 7,44€

### 4 Integrated Circuits

Quantity | References | Value | PCB Package | Farnell code
Cost
1 | U1 | ICE40HX4K-TQ144 | QFP50P2200X2200X160-144N | 3768754 | 9,170€
1 | | U2 | | IS25LP032D-JNLE | | SO8W | 2787053 | 0,858€
1 | | U3 | | MCP1725ADJ | | SO8 | 1834878 | 0,551€

1 | U4 | MCSJK-3N-16-3.3-50- B
MCSJK3N16003350B | 2854288 | 0,693€
Sub-totals: | 11,27€

### 5 Diodes

Quantity | References | Value | PCB Package | Farnell code
Cost
1 | D1 | 1N4448HWS | SOD-323 | 3127174 | 0,125€
4 | | D2,D3,D4,D5 | | HSMSC170 | | SOD123_K | 5790839 | 0,179€
Sub-totals: | 0,84€

### 14 Miscellaneous

Quantity | References | Value | PCB Package | Farnell code | Cost
9 | 1V2,1V2M,3V3,BLUE,GND,GREEN,HSYNC, RED,VSYNC | PIN | PIN | | 0€
2 | | J1,J2 | | M20-6102045 | | CONN-DIL40-ROUND | 1569230 | 4,05€
1 | | J3 | | L77HDE15SD1CH4F | | AHDF15AKGTASBR | 2401182 | 1,470€
2 | | MB0,MB1 | | 109296002381906 | | CONN-SIL2 | 2932817 | 0,569€
Sub-totals: | 10,71€
Totals: | 33,65€ viernes, 24 de octubre de 2025 0:46:57
