medpar/TP1/Planificacion/BOM/BOM2.pdf

### Universidad de Valladolid Desarrollo Práctico de Sistemas Electrónicos


### Bill Of Materials for Taller Proyectos 1. Datalogger

Design Title | Taller Proyectos 1. Datalogger
Author | VIMMAC TECH
Document Number | 1
Revision | 3
Board | PCB2-Sensors
Design Created | miércoles, 21 de septiembre de 2022
Design Last Modiied viernes, 24 de octubre de 2025 Total Parts In Design 55

Notes
Precios sin IVA (21%), VAT not added
No incluyen gastos de envio, shipping costs not included
Algunos valores corresponden con la compra de 10 uds o más, Some values correspond to the purchase of 10 units or more.

### 5 Modules

Quantity | References | Value | PCB Package | Farnell code
Cost
1 | M1 | BME680_MODULE | BME680_MODULE | 3932094 | 19,290€
1 | | M2 | | GP2Y1010AU0F | | GP2Y1010AU0F | 9707956 | 7,830€
1 | M3 | GPS_TEL0132 | GPS_TEL0132 | 3769990 | 15,280€
1 | | M4 | | SEN0134 | | SEN0134 | 2946118 | 6,4€
1 | M2_ON | PIN | PIN | | 0€
Sub-totals: | 48,80€

### 6 Capacitors

Quantity | References | Value | PCB Package | Farnell code | Cost
3 | C1,C2,C3 | 1uF | 0805 | | 0,0736€
2 | | C4,C5 | | 10uF | | 0805 | | 0,0545€
1 | | C6 | | EEEFK1V221P | | C6 | 9695877 | 0,390€
Sub-totals: | 0,72€

### 11 Resistors

Quantity | References | Value | PCB Package | Farnell code
Cost
6 | R1,R2,R5,R6,R7,R11 | 10k | 0805 | | 0,175€
1 | | R3 | | 6K8 | | 0805 | 0,366€
1 | R4 | 1K2 | 0805 | | 0,366€
1 | | R8 | | 820R | | 0805 | 0,0887€
1 | R9 | 470R | 0805 | | 0,0407€
1 | | R10 | | 150R | | 0805 | 0,0585€
Sub-totals: | 1,97€

### 3 Integrated Circuits

Quantity | References | Value | PCB Package | Farnell code
Cost
1 | U1 | MS8607-02BA01 | QFN_5X3_NEG | 2748850 | 7,980€
1 | | U2 | | MCP3004-I/SL | | SO14 | 1852016 | 2,190€
1 | U3 | XC9141B50DMR-G | SOT23-5 | 3535653 | 0,764€

Sub-totals: | 10,93€

### 4 Transistors

Quantity | References | Value | PCB Package | Farnell code
Cost
3 | Q1,Q3,Q4 | MMBT3904-7-F | SOT95P230X109-3 | 1773602 | 0,110€
1 | | Q2 | | NDS332P | | SOT23 | 1471069 | 0,527€
Sub-totals: | 0,86€

### 26 Miscellaneous

Quantity | References | Value | PCB Package | Farnell code
Cost
21 | 3V3,5V_CE,5V_M4,5V_UP,ADCCS,BMECS,CH0, CH1,CH2,CH3,EN1V4,EN5V,GND,GPS_RX,GPS_TX, ICEMISO,ICEMOSI,ICESCK,P25,SCL,SDA | PIN | PIN | | 0€
1 | | J1 | | ZHR-6 | | JST_ZHR-6 | | 3357570 | 0,0665€
2 | J2,J3 | M20-6102045 | CONN-DIL40-ROUND | 1569230 | 4,05€
1 | | J4 | | S6BZRSM4ATFLFSN | JST_S6BZRSM4ATFLFSN | 1830924 | 0,532€
1 | L1 | LQH5BPNR47NT0L | L1 | 2219309 | 0,265€
Sub-totals: | 8,96€
Totals: | 72,24€ viernes, 24 de octubre de 2025 1:15:24
