medpar/TP1/Planificacion/BOM/BOM3.pdf

### Universidad de Valladolid Desarrollo Práctico de Sistemas Electrónicos


### Bill Of Materials for Taller Proyectos 1. Datalogger

Design Title | Taller Proyectos 1. Datalogger
Author | VIMMAC TECH
Document Number | 1
Revision | 3
Board | PCB3-Wireless
Design Created | martes, 7 de octubre de 2025
Design Last Modiied viernes, 10 de octubre de 2025 Total Parts In Design 19

Notes
Precios sin IVA (21%), VAT not added
No incluyen gastos de envio, shipping costs not included
Algunos valores corresponden con la compra de 10 uds o más, Some values correspond to the purchase of 10 units or more. **Fuera de stock, referencia DigiKey: AP3216ID

### 1 Modules

Quantity | References | Value | PCB Package | Farnell code | Cost
1 | M3 | LAMBDA62-8D | LAMBDA628D | 2988568 | 14,44€
Sub-totals: | 14,44€

### 3 Capacitors

Quantity | References | Value | PCB Package | Farnell code | Cost
1 | C1 | 100nF | 0805 | | 0,168€
2 | | C2,C3 | | | 0805
Sub-totals: | 0,17€

### 1 Resistors

Quantity | References | Value | PCB Package | Farnell code | Cost
1 | R1 | 10k | 0805 | | 0,175€
Sub-totals: | 0,17€

### 14 Miscellaneous

Quantity | References | Value | PCB Package | Farnell code | Cost
10 | 3V3,GND,LBUSY,LCS,LDI01,LMISO,LRX,LSCK,LTX,MOSI | PIN | PIN | | 0€
1 | | ANT 1 | | ANT25_26 | | NULL
2 | J1,J2 | M20-6102845 | CONN-DIL40-ROUND | 1569230 | 4,05€
1 | | L1 | | | 0805
Sub-totals: | 8,10€
Totals: | 22,88€ viernes, 10 de octubre de 2025 16:04:32
