medpar/TP1/Hardware/Imagenes esquematicos y PCBs/PCB0_bottom.pdf

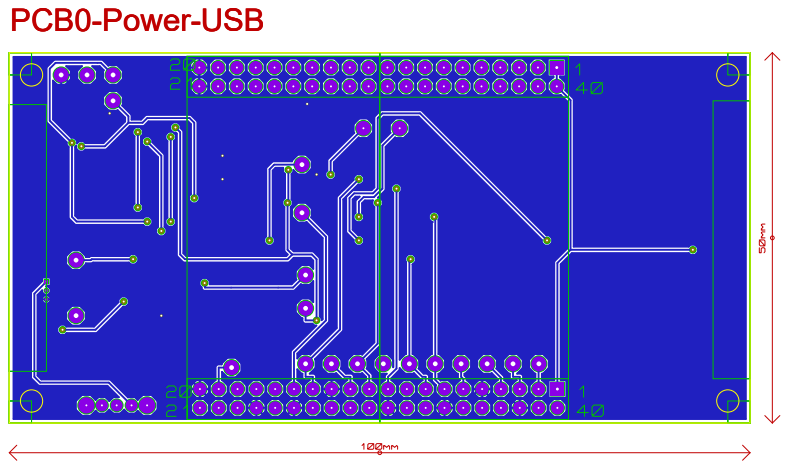
[picture p31: page 1]
PCB0-Power-USB
