medpar/TP1/Hardware/Imagenes esquematicos y PCBs/PCB0_top.pdf

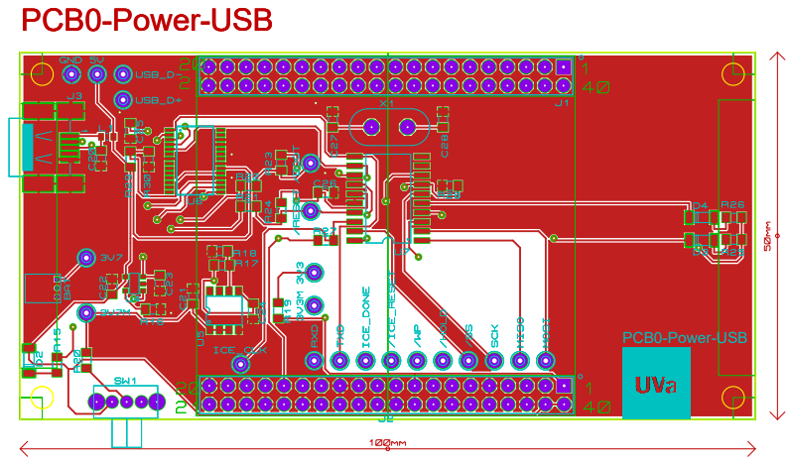
[picture p32: page 1]
PCB0-Power-USB
