medpar/TP1/Hardware/Imagenes esquematicos y PCBs/PCB1_bottom.pdf

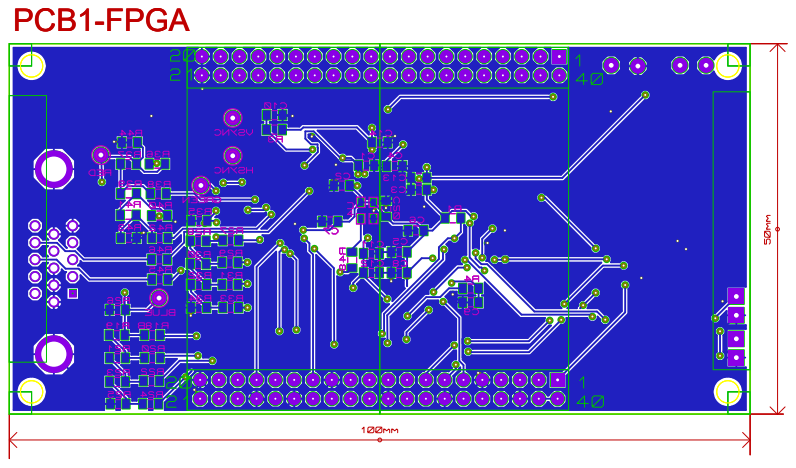
[picture p33: page 1]
PCB1-FPGA
