medpar/TP1/Hardware/Imagenes esquematicos y PCBs/PCB1_top.pdf

# PCB1-FPGA

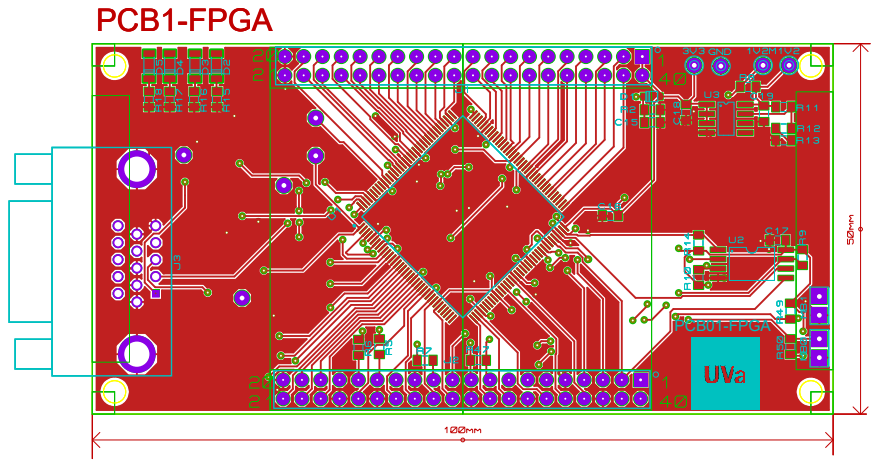
[picture p34: page 1]
PCB01-FPGA
