medpar/TP1/Hardware/Imagenes esquematicos y PCBs/PCB2_bottom.pdf

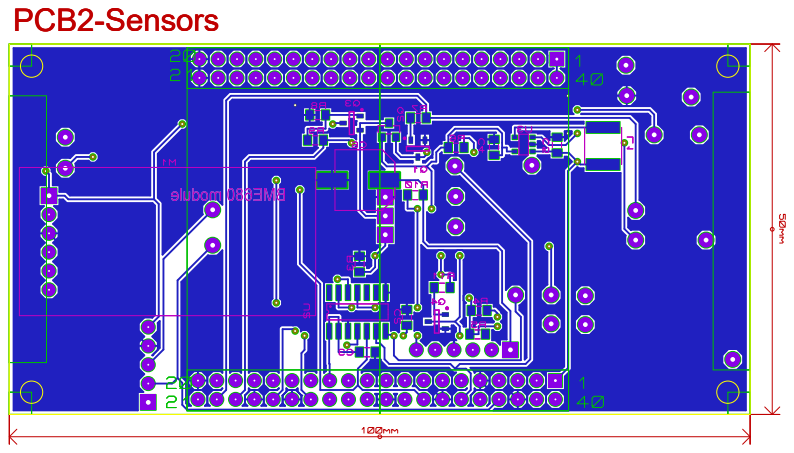
[picture p35: page 1]
PCB2-Sensors
