medpar/TP1/Hardware/Imagenes esquematicos y PCBs/PCB2_top.pdf

# PCB2-Sensors

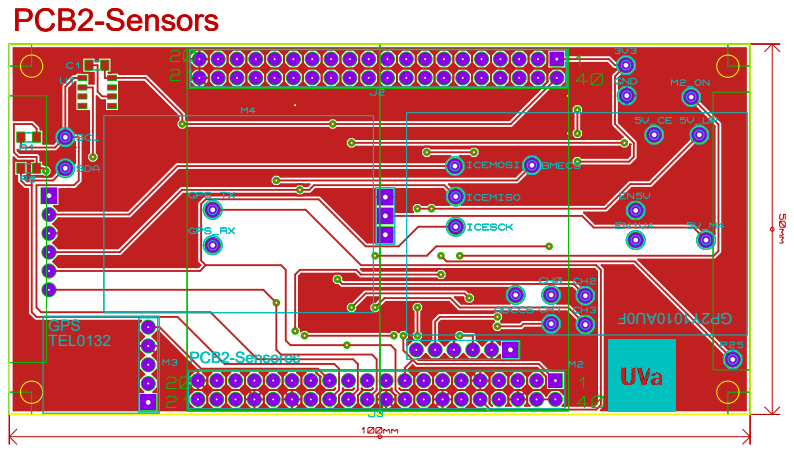
[picture p36: page 1]
PCB2-Sensores; TEL0132; GPS
