medpar/TP1/Hardware/Imagenes esquematicos y PCBs/PCB3_bottom.pdf

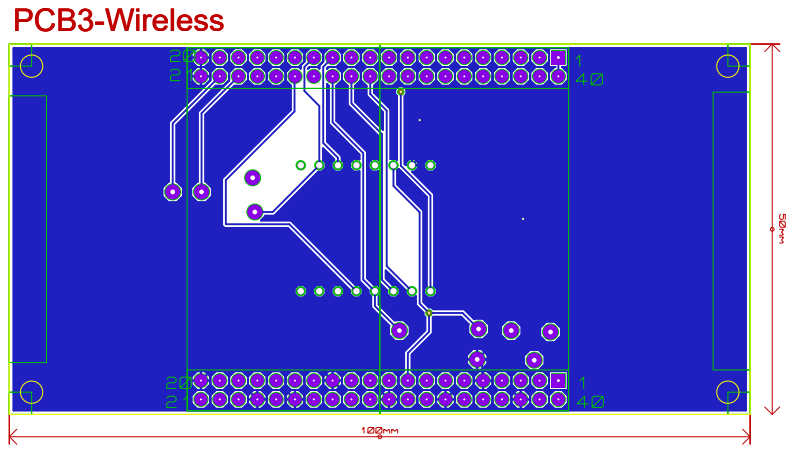
[picture p37: page 1]
PCB3-Wireless
