medpar/TP1/Hardware/Imagenes esquematicos y PCBs/PCB3_top.pdf

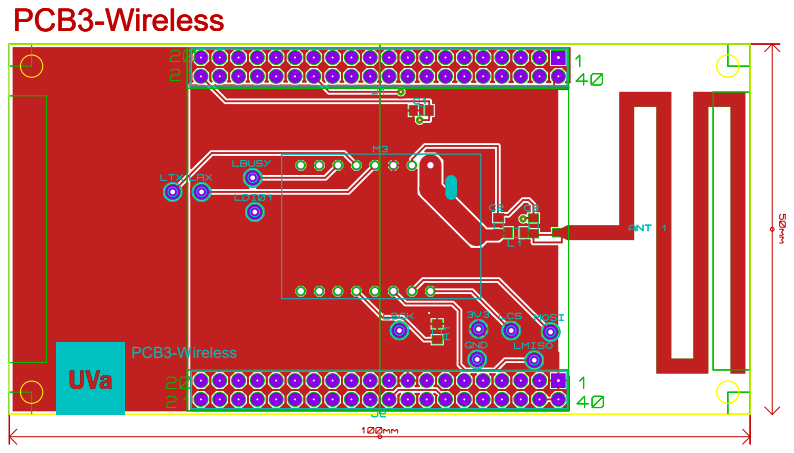
[picture p38: page 1]
PCB3-Wireless
