medpar/TP1/(list of files, drawings)

Other design files:
Hardware/Project Backups/TP1_G1_2 [20251007, 11-02-02].pdsprj
Hardware/Project Backups/TP1_G1_2 [20251010, 09-42-50].pdsprj
Hardware/Project Backups/TP1_G1_2 [20251010, 10-18-33].pdsprj
Hardware/Project Backups/TP1_G1_2 [20251010, 10-18-34].pdsprj
Hardware/Project Backups/TP1_G1_2 [20251010, 10-18-35].pdsprj
Hardware/Project Backups/TP1_G1_2 [20251010, 10-23-20].pdsprj
Hardware/Project Backups/TP1_G1_2 [20251010, 10-27-43].pdsprj
Hardware/Project Backups/TP1_G1_2 [20251010, 10-30-44].pdsprj
Hardware/Project Backups/TP1_G1_2 [20251010, 10-41-20].pdsprj
Hardware/Project Backups/TP1_G1_2 [20251010, 10-41-21].pdsprj
Hardware/Project Backups/TP1_G1_2 [20251010, 10-41-59].pdsprj
Hardware/Project Backups/TP1_G1_2 [20251010, 10-42-00].pdsprj
Hardware/TP1_G1.pdsprj
