medpar/TP1/Software/laRVa_tp1_G1/Firmware/main.c

//////////////////////////////////////////////////////////////////
//	TP1 - Sistemas electrónicos									//
//	Grupo 1:												  	//
//  Clara Ruiz de las Heras, Mario Medrano Paredes,				//
//  Miguel Barrigón Gómez, Víctor Sánchez Valencia			    //
//////////////////////////////////////////////////////////////////

#include <stdint.h>

// Modulos externos
#include "moduloMQ9.h"
#include "moduloBME680.h"
#include "moduloTEL0132.h"
#include "lora_sx1262.h"
#include "moduloMCP3004.h"
#include "moduloGP2Y1010.h"
#include "SPI.h"

// Tipos de datos
typedef unsigned char  u8;
typedef unsigned short u16;
typedef unsigned int   u32;

typedef signed char  s8;
typedef signed short s16;
typedef signed int   s32;

// Estado de la secuencia del sensor MQ9 (usado por el timer IRQ)
volatile int estado;  


// UART0
#define UARTDAT  (*(volatile uint8_t*)0xE0000080)
#define UARTSTA  (*(volatile uint32_t*)0xE0000084)
#define UARTBAUD (*(volatile uint32_t*)0xE0000084)

// UART1
#define UART1DAT  (*(volatile uint8_t*)0xE0000090)
#define UART1STA  (*(volatile uint32_t*)0xE0000094)
#define UART1BAUD (*(volatile uint32_t*)0xE0000094)

// UART2
#define UART2DAT  (*(volatile uint8_t*)0xE00000A0)
#define UART2STA  (*(volatile uint32_t*)0xE00000A4)
#define UART2BAUD (*(volatile uint32_t*)0xE00000A4)

// SPI
#define SPIDAT	 (*(volatile uint32_t*)0xE0000070)
#define SPICTRL	 (*(volatile uint32_t*)0xE0000074)
#define SPISTA	 (*(volatile uint32_t*)0xE0000074)
#define SPISS	 (*(volatile uint32_t*)0xE0000078)

//SPI1
#define SPI1DAT	 (*(volatile uint32_t*)0xE0000060)
#define SPI1CTRL (*(volatile uint32_t*)0xE0000064)
#define SPI1STA	 (*(volatile uint32_t*)0xE0000064)
#define SPI1SS	 (*(volatile uint32_t*)0xE0000068)

// TIMER
#define MAX_COUNT (*(volatile uint32_t*)0xE0000040)
#define TIMER     (*(volatile uint32_t*)0xE0000040)

// GPOUT
#define GPOUT  (*(volatile uint32_t*)0xE0000030)
#define GPIN   (*(volatile uint32_t*)0xE0000034)

#define LORA_RESET  (1U << 10)
#define L_RX        (1U << 9)
#define L_TX        (1U << 8)
#define EN_5V_UP    (1U << 7)
#define EN_5V_M4    (1U << 6)
#define EN_1V4_M4   (1U << 5)
#define M2_ON_OFF   (1U << 4)
#define LED3        (1U << 3)
#define LED2        (1U << 2)
#define LED1        (1U << 1)
#define LED0        (1U << 0)

#define SENSOR_POWER (EN_5V_UP | EN_5V_M4 | EN_1V4_M4)

// Bits de interrupcion
#define IRQ_TIMER     (1U << 1)
#define IRQ_UART0_RX  (1U << 2)
#define IRQ_UART0_TX  (1U << 3)
#define IRQ_UART1_RX  (1U << 4)
#define IRQ_UART1_TX  (1U << 5)
#define IRQ_UART2_RX  (1U << 6)
#define IRQ_UART2_TX  (1U << 7)

//Vectores de interrupcion
#define IRQEN	 (*(volatile uint32_t*)0xE0000020) //Enable
#define IRQVECT0 (*(volatile uint32_t*)0xE0000000) //Trap
#define IRQVECT1 (*(volatile uint32_t*)0xE0000004) //Timer
#define IRQVECT2 (*(volatile uint32_t*)0xE0000008) //UART0 RX
#define IRQVECT3 (*(volatile uint32_t*)0xE000000C) //UART0 TX
#define IRQVECT4 (*(volatile uint32_t*)0xE0000010) //UART1 RX
#define IRQVECT5 (*(volatile uint32_t*)0xE0000014) //UART1 TX
#define IRQVECT6 (*(volatile uint32_t*)0xE0000018) //UART2 RX
#define IRQVECT7 (*(volatile uint32_t*)0xE000001C) //UART2 TX

void delay_loop(uint32_t val);

#define CCLK (18000000u)
#define _delay_us(n) delay_loop((n*(CCLK/1000)-3000)/3000)
#define _delay_ms(n) delay_loop((n*(CCLK/1000)-30)/3)


void _putch(int c) { 
	while((UARTSTA &2)==0); 
	UARTDAT  = c; 
}


void _puts(const char *p)
{
    while (*p)
       _putch(*(p++)); 
}

/*
uint8_t _getch()
{
	while((UARTSTA&1)==0);
	return UARTDAT;
}

uint8_t haschar() {return UARTSTA&1;}
*/

//FIFOs
uint8_t udat0[32]; 				//FIFO UART0
volatile uint8_t rdix0, wrix0;

uint8_t udat1[32]; 				//FIFO UART1
volatile uint8_t rdix1, wrix1;

uint8_t udat2[32]; 				//FIFO UART2
volatile uint8_t rdix2, wrix2;

// Buffer para LoRa
static uint8_t lora_rx_buffer[128];

// Funciones para comprobar si hay datos en los FIFOs
uint8_t hascharUART0(void);
uint8_t hascharUART1(void);
uint8_t hascharUART2(void);

//Lectura de la UART0
uint8_t _getchUART0()
{
	uint8_t d;
	while(rdix0==wrix0);
	d=udat0[rdix0++];
	rdix0 &=31;
	return d;
}

//Lectura de la UART1
uint8_t _getchUART1()
{
	uint8_t d;
	while(rdix1==wrix1);
	d=udat1[rdix1++];
	rdix1 &=31;
	return d;
}

//Lectura de la UART2
uint8_t _getchUART2()
{
	uint8_t d;
	while(rdix2==wrix2);
	d=udat2[rdix2++];
	rdix2 &=31;
	return d;
}
 
void *memcpy(void *dst, const void *src, unsigned int n)
{
	unsigned char *d = (unsigned char *)dst;
	const unsigned char *s = (const unsigned char *)src;

	while (n--) {
		*d++ = *s++;
	}
	return dst;
}

extern int _printf(const char *format, ...);
extern int _sprintf(char *out, const char *format, ...);

static void split_temp_centi(int temp_centi, char *sign, int *int_part, int *frac_part)
{
	int abs_val = temp_centi;
	if (temp_centi < 0) {
		*sign = '-';
		abs_val = -temp_centi;
	} else {
		*sign = ' ';
	}
	*int_part = abs_val / 100;
	*frac_part = abs_val % 100;
}

// Funcion para debug de sensores
static void debug_sensores(void)
{
	// Lectura completa de sensores y salida por UART
	int temp_comp, press_comp, hum_comp;
	int adc0, adc1, adc2, adc3;
	int co_ppm, ch4_ppm;
	int dust_raw;

	inicia_BME();
	temp_comp  = devuelve_temp();
	press_comp = devuelve_pres();
	hum_comp   = devuelve_hum(temp_comp);

	adc0 = lee_MCP(MCP_0);
	adc1 = lee_MCP(MCP_1);
	adc2 = lee_MCP(MCP_2);
	adc3 = lee_MCP(MCP_3);

	co_ppm  = lee_MQ9_CO(MCP_0);
	ch4_ppm = lee_MQ9_CH4(MCP_0);

	dust_raw = lee_GP2Y(MCP_1);

	char temp_sign;
	int temp_int, temp_frac;
	split_temp_centi(temp_comp, &temp_sign, &temp_int, &temp_frac);

	_printf("\n------ DEBUG SENSORES ------\n");
	_printf("BME680 T=%c%d.%02dC, P=%d Pa, H=%02d.%03d %%\n",
	        temp_sign, temp_int, temp_frac,
	        press_comp,
	        hum_comp/1000, hum_comp%1000);
	_printf("ADC CH0=%d CH1=%d CH2=%d CH3=%d\n", adc0, adc1, adc2, adc3);
	_printf("MQ9 CO=%d ppm, CH4=%d ppm\n", co_ppm, ch4_ppm);
	_printf("GP2Y1010 raw=%d\n", dust_raw);
	_printf("----------------------------\n");
	lee_GPS();
}

// Funcion para envio continuo de LoRa
static void lora_continuo(void)
{
	int temp_comp, press_comp, hum_comp;
	int lat_micro = 0;
	int lon_micro = 0;
	char payload[160];
	unsigned int msg_id = 0;

	_puts("Envio LoRa continuo (pulsa cualquier tecla para volver al menu)\n");

	if (!SX1262_Init()) {
		_printf("Error al iniciar el LoRa\n");
		return;
	}
	SX1262_configSetFrequency(868000000);	// 868 MHz
	SX1262_configSetBandwidth(4);      	  	// 125 kHz
	SX1262_configSetSpreadingFactor(7);  	// SF7

	while (1) {
		if (hascharUART0()) {
			// Cualquier tecla detiene el envío continuo
			_getchUART0();
			break;
		}
		inicia_BME();
		temp_comp  = devuelve_temp();
		press_comp = devuelve_pres();
		hum_comp   = devuelve_hum(temp_comp);

		// GPS en microgrados (si falla, deja 0)
		if (!GPS_lee_latlon_micro(&lat_micro, &lon_micro)) {
			lat_micro = 0;
			lon_micro = 0;
		}

		payload[0] = '\0';
		char temp_sign;
		int temp_int, temp_frac;
		split_temp_centi(temp_comp, &temp_sign, &temp_int, &temp_frac);
		int len = _sprintf(payload,
		                   "|Grupo 1,T=%c%d.%02dC,H=%2d.%03d%%,P=%d Pa,LAT= %10d,LON= %10d",
		                   temp_sign, temp_int, temp_frac,
		                   hum_comp/1000, hum_comp%1000,
		                   press_comp,
		                   lat_micro, lon_micro);
		if (len < 0) len = 0;
		if (len >= (int)sizeof(payload)) len = (int)sizeof(payload) - 1;
		payload[len] = '\0';

		SX1262_transmit((uint8_t *)payload, len);
		SX1262_readPacketStatus();
		_printf("rssi %4d, snr %4d ## %5u %s\n",
		        SX1262_rssi, SX1262_snr, (unsigned long)msg_id, payload);
		msg_id++;
		_delay_ms(1000);
	}
}


#define putchar(d) _putch(d)
#include "printf.c"
#include "moduloMQ9.c"
#include "moduloBME680.c"
#include "moduloTEL0132.c"
#include "lora_sx1262.c"
//#include "SPI.c"
#include "moduloMCP3004.c"
#include "moduloGP2Y1010.c"

// Menu principal y logo
const static char *menu="\n" 
"------------------ 	MENU  	  -----------------\n" 
"--------------------------------------------------\n" 
"|                                                |\n" 
"|    Seleccione: s -> Valores de los sensores    |\n" 
"|    Seleccione: f -> Sensor de gases            |\n" 
"|    Seleccione: p -> Polvo GP2Y1010             |\n" 
"|    Seleccione: a -> ADC MCP3004                |\n" 
"|    Seleccione: r -> Recibir LoRa               |\n" 
"|    Seleccione: t -> Transmitir LoRa            |\n" 
"|    Seleccione: c -> Envio LoRa continuo        |\n" 
"|    Seleccione: g -> GPS                        |\n" 
"|    Seleccione: d -> Debug de sensores          |\n" 
"|    Seleccione: e -> Logo del equipo            |\n" 
"|    Seleccione: q -> Salir                      |\n" 
"|                                                |\n" 
"--------------------------------------------------\n"  
"\n\n";

const static char *menutxt="        TP1 Grupo1 - laRVa IoT logger\n";

const static char *logo="\n\n"
"       | | | |                       ( | )  \n"
"     +---------+                    (  |  ) \n"
"  ---|         |                       |   \n"
"  ---|  VIMMAC |-----------------------|   \n"
"  ---|         |                       |   \n"
"     +---------+                      / \\  \n"
"       | | | |                       /   \\ \n"
"											\n"
"\n"
"   V     V  III  M     M  M     M   AAAAA   CCCCC\n"
"   V     V   I   MM   MM  MM   MM  A     A  C\n"
"    V   V    I   M M M M  M M M M  AAAAAAA  C\n"
"     V V     I   M  M  M  M  M  M  A     A  C\n"
"      V     III  M     M  M     M  A     A  CCCCC\n"
"\n"
"            _____ _____ ____ _   _ \n"
"           |_   _| ____/ ___| | | |\n"
"             | | |  _|| |   | |_| |\n"
"             | | | |__| |___|  _  |\n"
"             |_| |_____\\____|_| |_|\n"
"									\n"
"        	TP1 ELECTRONICS\n"
"\n\n";

// Funciones para comprobar si hay datos en los FIFOs
uint8_t hascharUART0(){return (wrix0 - rdix0) & 31;}

uint8_t hascharUART1(){return (wrix1 - rdix1) & 31;}

uint8_t hascharUART2(){return (wrix2 - rdix2) & 31;}

// Funcion para obtener el PC de la interrupcion
uint32_t __attribute__((naked)) getMEPC()
{
	asm volatile(
	//"	csrrw	a0,0x341,zero	\n"
	//"	csrrw	zero,0x341,a0	\n"
	"	.word	0x34101573 		\n"
	"	.word   0x34151073		\n"
	"	ret						\n"
	);
}

//Interrupciones
void __attribute__((interrupt ("machine"))) irq0_handler()
{
	_printf("\nTRAP at 0x%x\n",getMEPC());
}

//Timer
void __attribute__((interrupt ("machine"))) irq1_handler()
{
	IRQEN &= ~IRQ_TIMER;
	switch(estado){
		case 0:
			lee_CO();
			break;
		case 1:
			lee_CH4();
			break;
		case 2:
			_printf("Medidas \n");
			break;
		default:
			break;
	}
	
}

//UART0 RX
void __attribute__((interrupt ("machine"))) irq2_handler()
{
    udat0[wrix0++] = UARTDAT;
    wrix0 &= 31;
}

//UART0 TX
void  __attribute__((interrupt ("machine"))) irq3_handler(){
	static uint8_t a=32;
	UARTDAT=a;
	if (++a>=128) a=32;
}

//UART1 RX
void __attribute__((interrupt ("machine"))) irq4_handler()
{
	udat1[wrix1++] = UART1DAT;
	wrix1 &= 31;
}

//UART1 TX
void  __attribute__((interrupt ("machine"))) irq5_handler(){
	static uint8_t a=32;
	UART1DAT=a;
	if (++a>=128) a=32;
}

//UART2 RX
void __attribute__((interrupt ("machine"))) irq6_handler()
{
    udat2[wrix2++] = UART2DAT;
    wrix2 &= 31;
}

//UART2 TX
void  __attribute__((interrupt ("machine"))) irq7_handler(){
	static uint8_t a=32;
	UART2DAT=a;
	if (++a>=128) a=32;
}


// --------------------------------------------------------

uint8_t spi_transf (uint8_t d)
{
	SPIDAT=d;
	while(SPISTA&1);
	return SPIDAT;
}
uint8_t spi1xfer (uint8_t d) 
{ 
SPI1DAT=d; 
while(SPI1STA&1); 
return SPI1DAT; 
}

// --------------------------------------------------------

#define BAUD 115200u
#define BAUD1 9600u
#define BAUD2 115200u
#define NULL ((void *)0)

static inline int abs_i(int x) { return (x < 0) ? -x : x; }

// Funcion principal
void main()
{

	char c,buf[17];
	uint8_t *p;
	unsigned int i,j;
	int n;
	void (*pcode)();
	uint32_t *pi;
	uint16_t *ps;
	int temp_comp, press_comp, hum_comp;
/*
    UARTBAUD=(CCLK+BAUD/2)/BAUD -1;	
	c = UARTDAT;		// Clear RX garbage
	
	IRQVECT2=(uint32_t)irq2_handler;
    IRQEN = (1<<2);
*/	
	
	// Inicializacion de SPI y UARTs
	SPICTRL=(8<<8)|8; 					// SPI control register 0 
	SPI1CTRL=(8<<8)|8; 					// SPI control register 1 
	SPISS = 0b11;
	SPI1SS = 1;
	UARTBAUD=(CCLK+BAUD/2)/BAUD -1;	    // UART0 baud rate
	UART1BAUD = (CCLK+BAUD1/2)/BAUD1 -1;	// UART1 baud rate (GPS)
	UART2BAUD = (CCLK+BAUD2/2)/BAUD2 -1;	// UART2 baud rate

	// Enciende las alimentaciones necesarias y deja el SX1262 fuera de reset.
	GPOUT = SENSOR_POWER | LORA_RESET;

	//_delay_ms(100);
	
	// Limpiar los FIFOs
	c = UARTDAT;	
	c = UART1DAT;	
	c = UART2DAT;	
	
	// Asignar las funciones de interrupcion
	IRQVECT0=(uint32_t)irq0_handler;	
	IRQVECT1=(uint32_t)irq1_handler;
	IRQVECT2=(uint32_t)irq2_handler;
	IRQVECT3=(uint32_t)irq3_handler;
	IRQVECT4=(uint32_t)irq4_handler;
	IRQVECT5=(uint32_t)irq5_handler;
	IRQVECT6=(uint32_t)irq6_handler;
	IRQVECT7=(uint32_t)irq7_handler;

	// Habilitar IRQ de RX en UART0 (bit 2).
	IRQEN = IRQ_UART0_RX;

	// Activar TIMER como contador libre para timeouts
	MAX_COUNT = 0xFFFFFFFFu;

	asm volatile ("ecall");
	asm volatile ("ebreak");
	_puts(logo);
	_puts(menutxt);
	
	// Bucle principal del menu
	while (1)
	{
		_puts(menu);
		char cmd = _getchUART0();
	
		if (cmd > 32 && cmd < 127)
			_putch(cmd);
			_puts("\n");
	
		switch (cmd)
		{
			case '2':
				IRQEN ^= 3;   // Toggle IRQ enable for UART TX
				_delay_ms(100);
				break;
	
			// Transmisión del modulo LoRa
			case 't':
			if(SX1262_Init()){
				_printf("Modulo LoRa iniciado\n");
				SX1262_configSetFrequency(868000000);
				SX1262_configSetBandwidth(4);      		// 125KHz
				SX1262_configSetSpreadingFactor(7); 	//SF7
				SX1262_transmit((uint8_t *)"Grupo 1", (int)(sizeof("Grupo 1") - 1));
			}
				else
				{
					_printf("Error al iniciar el LoRa\n");
				}
				break;
	
			// Recepción del modulo LoRa
			case 'r':
				if (SX1262_Init())
				{
					_printf("Modo recepcion LoRa (tecla para salir)\n");
					SX1262_configSetFrequency(868000000);
					SX1262_configSetBandwidth(4);      	  //125 kHz
					SX1262_configSetSpreadingFactor(7);  //SF7

					while (!hascharUART0()) {
						n = SX1262_lora_receive_async(lora_rx_buffer, sizeof(lora_rx_buffer));
						if (n > 0)
						{
							_printf("Paquete recibido (%d bytes): ", n);
							for (i = 0; i < (unsigned int)n; i++)
								_putch(lora_rx_buffer[i]);
							_puts("\n");
						}
						_delay_ms(200);
					}
					_getchUART0(); // limpiar la tecla
				}
				else
				{
					_printf("Error al iniciar el LoRa\n");
				}
				break;
	

			// Envio continuo LoRa
			case 'c':
				lora_continuo();
				break;

			// Sensores de humedad, temperatura y presion
			case 's':
				inicia_BME();
	
				temp_comp  = devuelve_temp();
				press_comp = devuelve_pres();
				hum_comp   = devuelve_hum(temp_comp);
	
				_printf("MEDIDAS DE PRESION, HUMEDAD Y TEMPERATURA\n");
				_printf("----------------------------------------------\n");
				_printf("\n");
	
				_printf(" La temperatura registrada es: ");
				_printf("%02d.%d%cC", temp_comp / 100, temp_comp % 100, 167);
	
				_printf("\n La presion registrada es: ");
				_printf("%d Pascales", press_comp);
	
				_printf("\n La humedad registrada es: ");
				_printf("%02d.%03d%c", hum_comp / 1000, hum_comp % 1000, 37);
	
				_printf("\n\n");
				_printf("----------------------------------------------\n");
				break;
	
			// Sensor de polvo GP2Y1010
			case 'p': {
				int raw = lee_GP2Y(MCP_1);
				_printf("Lectura GP2Y1010 ADC (valores entre 0-1023): %d \n", raw);
				break;
			}
			// Lectura ADC directa
			case 'a': {
				int adc0 = lee_MCP(MCP_0);
				int adc1 = lee_MCP(MCP_1);
				int adc2 = lee_MCP(MCP_2);
				int adc3 = lee_MCP(MCP_3);
				_printf("Lectura ADC MCP3004:\nCH0=%d\nCH1=%d\nCH2=%d\nCH3=%d\n", adc0, adc1, adc2, adc3);
				break;
			}

			// GPS
			case 'g':
				lee_GPS();
				break;

			// Debug completo de todos los sensores
			case 'd':
				debug_sensores();
				break;
	
			// Logo del Grupo 1
			case 'e':
				_puts(logo);
				break;
	
			// Salir del menu
			case 'q':
				return;
	
			// Medidas del sensor de gases
			case 'f':
			{
				int co_ppm = lee_MQ9_CO(MCP_0);
				int ch4_ppm = lee_MQ9_CH4(MCP_0);
				_printf("---- MQ9 ----\nCO: %d ppm\nCH4: %d ppm\n", co_ppm, ch4_ppm);
				break;
			}
	
			default:
				continue;	
		}
	}
}
