medpar/TP1/Software/laRVa_tp1_G1/timer.v

//////////////////////////////////////////////////////////////////
//	TP1 - Sistemas electrónicos									//
//	Grupo 1:												  	//
//  Clara Ruiz de las Heras, Mario Medrano Paredes,				//
//  Miguel Barrigón Gómez, Víctor Sánchez Valencia			    //
//////////////////////////////////////////////////////////////////



// Contador de periodos
module TIMER( 
input clk, 
input rd, 
input wr, 
input [31:0] maximo, 

output reg flag_temp,
output reg [31:0] cont
); 

reg [31:0]aux=0; 

// Ponemos los valores iniciales a 0
initial 
begin  
cont = 0; 
flag_temp = 0; 
end 

// Contador sincronizado con el reloj del sistema
always @(posedge clk) 
begin 
// Escritura: carga nuevo periodo y reinicia contador/bandera
if (wr)  
begin 
aux <= maximo; 
cont <= 0; 
flag_temp <= 0; 
end 
if(aux > 0) 
begin 
// Lectura: limpia la bandera para detectar nuevo evento
if(rd)  
flag_temp <= 0; 
// Compara con el periodo ajustado por el reloj (18)
if(cont == aux*18) 
begin 
cont <= 0; 
flag_temp <= 1; 
end 
else 
cont <= (cont+1); 
end 
end 
endmodule
