medpar/TP1/Software/tools_viejas/lpc11loader/chips.c

static const struct {
char *name;
unsigned int id;
} flash_chips[]={


"AMIC_A25L05PT",0x372020,
"AMIC_A25L05PU",0x372010,
"AMIC_A25L10PT",0x372021,
"AMIC_A25L10PU",0x372011,
"AMIC_A25L20PT",0x372022,
"AMIC_A25L20PU",0x372012,
"AMIC_A25L40PT",0x372013,
"AMIC_A25L40PU",0x372013,
"AMIC_A25L80P",0x372014,	/* Seems that no A25L80PT exists */
"AMIC_A25L16PT",0x372025,
"AMIC_A25L16PU",0x372015,
"AMIC_A25L512",0x373010,
"AMIC_A25L010",0x373011,
"AMIC_A25L020",0x373012,
"AMIC_A25L040",0x373013,
"AMIC_A25L080",0x373014,
"AMIC_A25L016",0x373015,
"AMIC_A25L032",0x373016,
"AMIC_A25LQ16",0x374015,
"AMIC_A25LQ032",0x374016,	/* Same as A25LQ32A, but the latter supports SFDP */
"AMIC_A25LQ64",0x374017,

"ATMEL_AT25DF021",0x1F4300,
"ATMEL_AT25DF021A",	0x1F4301,
"ATMEL_AT25DF041A",	0x1F4401,
"ATMEL_AT25DF081",0x1F4502,	/* EDI 0x00. AT25DL081 has same ID + EDI 0x0100 */
"ATMEL_AT25DF081A",	0x1F4501,	/* Yes, 81A has a lower number than 81 */
"ATMEL_AT25DF161",0x1F4602,
"ATMEL_AT25DF321",0x1F4700,	/* Same as 26DF321 */
"ATMEL_AT25DF321A",	0x1F4701,
"ATMEL_AT25DF641",0x1F4800,
"ATMEL_AT25DL161",0x1F4603,	/* EDI 0x0100 */
"ATMEL_AT25DQ161",0x1F8600,	/* EDI 0x0100 */
"ATMEL_AT25DQ321",0x1F8700,	/* EDI 0x0100 */
"ATMEL_AT25F512B",0x1F6500,
"ATMEL_AT25FS010",0x1F6601,
"ATMEL_AT25FS040",0x1F6604,
"ATMEL_AT25SF041",0x1F8401,
"ATMEL_AT25SF081",0x1F8501,
"ATMEL_AT25SF161",0x1F8601,
"ATMEL_AT25SF321",0x1F8701,
"ATMEL_AT25SL128A",	0x1F4218,
"ATMEL_AT25SF128A",	0x1F8901, /* Adesto AT25SF128A */

"ESMT_F25L008A",0x8C2014,
"ESMT_F25L32PA",0x8C2016,
"ESMT_F25D08QA",0x8C2534,
"ESMT_F25L16QA2S",0x8C4015,
"ESMT_F25L32QA",0x8C4016,
"ESMT_F25L32QA2S",0x8C4116,
"ESMT_F25L64QA",0x8C4117,
"ESMT_F25L128QA",0x8C4118,

"EON_EN25B05",0x1C2010,	/* Same as EN25P05, can be distinguished by RES/REMS: */
"EON_EN25B10",0x1C2011,	/* Same as EN25P10, can be distinguished by RES/REMS: */
"EON_EN25B20",0x1C2012,	/* Same as EN25P20, can be distinguished by RES/REMS: */
"EON_EN25B40",0x1C2013,	/* Same as EN25P40, can be distinguished by RES/REMS: */
"EON_EN25B80",0x1C2014,	/* Same as EN25P80, can be distinguished by RES/REMS: */
"EON_EN25B16",0x1C2015,	/* Same as EN25P16, can be distinguished by RES/REMS: */
"EON_EN25B32",0x1C2016,	/* Same as EN25P32, can be distinguished by RES/REMS: */
"EON_EN25B64",0x1C2017,	/* Same as EN25P64, can be distinguished by RES/REMS: */
"EON_EN25Q40",0x1C3013,
"EON_EN25Q80",0x1C3014,
"EON_EN25D16",0x1C3015,	/* Same as Q16 */
"EON_EN25Q32",0x1C3016,
"EON_EN25Q64",0x1C3017,
"EON_EN25Q128",0x1C3018,
"EON_EN25F05",0x1C3110,
"EON_EN25F10",0x1C3111,
"EON_EN25F20",0x1C3112,
"EON_EN25F40",0x1C3113,
"EON_EN25F80",0x1C3114,
"EON_EN25F16",0x1C3115,
"EON_EN25F32",0x1C3116,
"EON_EN25F64",0x1C3117,
"EON_EN25Q40",0x1C3013,
"EON_EN25Q80",0x1C3014,
"EON_EN25Q16",0x1C3015,/* Same as EN25D16 */
"EON_EN25Q32",0x1C3016,/* Same as EN25Q32A and EN25Q32B */
"EON_EN25Q64",0x1C3017,
"EON_EN25Q128",0x1C3018,
"EON_EN25QH16",0x1C7015,
"EON_EN25QH32",0x1C7016,
"EON_EN25QH64",0x1C7017,
"EON_EN25QH128",0x1C7018,
"EON_EN25QH256",0x1C7019,
"EON_EN25S10",0x1C3811,
"EON_EN25S20",0x1C3812,
"EON_EN25S40",0x1C3813,
"EON_EN25S80",0x1C3814,
"EON_EN25S16",0x1C3815,
"EON_EN25S32",0x1C3816,
"EON_EN25S64",0x1C3817,
"EON_EN25T80",0x1C5114,
"EON_EN25T16",0x1C5115,

"EXCEL_ES25P40",0x4A2013,
"EXCEL_ES25P80",0x4A2014,
"EXCEL_ES25P16",0x4A2015,

"FIDELIX_FM25M16",0xF84215,
"FIDELIX_FM25M32",0xF84216,
"FIDELIX_FM25M64",0xF84217,
"FIDELIX_FM25Q08",0xF83214,
"FIDELIX_FM25Q16",0xF83215, /* Same as FM25S16 (which is apparently single I/O only) */
"FIDELIX_FM25Q32",0xF83216,
"FIDELIX_FM25Q64",0xF83217,

"GIGADEVICE_GD25T80",	0xC83114,
"GIGADEVICE_GD25Q512",	0xC84010,
"GIGADEVICE_GD25Q10",	0xC84011,
"GIGADEVICE_GD25Q20",	0xC84012,	/* Same as GD25QB */
"GIGADEVICE_GD25Q40",	0xC84013,	/* Same as GD25QB */
"GIGADEVICE_GD25Q80",	0xC84014,	/* Same as GD25Q80B (which has OTP) */
"GIGADEVICE_GD25Q16",	0xC84015,	/* Same as GD25Q16B (which has OTP) */
"GIGADEVICE_GD25Q32",	0xC84016,	/* Same as GD25Q32B */
"GIGADEVICE_GD25Q64",	0xC84017,	/* Same as GD25Q64B */
"GIGADEVICE_GD25Q128",	0xC84018,	/* GD25Q128B and GD25Q128C only, can be distinguished by SFDP */
"GIGADEVICE_GD25Q256D",	0xC84019,
"GIGADEVICE_GD25VQ21B",	0xC84212,
"GIGADEVICE_GD25VQ41B",	0xC84213 , /* Same as GD25VQ40C, can be distinguished by SFDP */
"GIGADEVICE_GD25VQ80C",	0xC84214,
"GIGADEVICE_GD25VQ16C",	0xC84215,
"GIGADEVICE_GD25LQ40",	0xC86013,
"GIGADEVICE_GD25LQ80",	0xC86014,
"GIGADEVICE_GD25LQ16",	0xC86015,
"GIGADEVICE_GD25LQ32",	0xC86016,
"GIGADEVICE_GD25LQ64",	0xC86017,	/* Same as GD25LQ64B (which is faster) */
"GIGADEVICE_GD25LQ128CD",	0xC86018,
"GIGADEVICE_GD25WQ80E",	0xC86514,

"INTEL_25F160S33B8",	0x898911,	/* Same as 25F016S33B8 */
"INTEL_25F320S33B8",	0x898912,
"INTEL_25F640S33B8",	0x898913,
"INTEL_25F160S33T8",	0x898915,	/* Same as 25F016S33T8 */
"INTEL_25F320S33T8",	0x898916,
"INTEL_25F640S33T8",	0x898917,

"ISSI_IS25LP032",0x9D6016,
"ISSI_IS25LP064",0x9D6017,
"ISSI_IS25LP128",0x9D6018,
"ISSI_IS25LP256",0x9D6019,
"ISSI_IS25WP032",0x9D7016,
"ISSI_IS25WP064",0x9D7017,
"ISSI_IS25WP128",0x9D7018,
"ISSI_IS25WP256",0x9D7019,

"MACRONIX_MX25L512",	0xC22010,	/* Same as MX25L512E, MX25V512, MX25V512C */
"MACRONIX_MX25L5121E",	0xC22210,
"MACRONIX_MX25L1005",	0xC22011,	/* Same as MX25L1005C, MX25L1006E */
"MACRONIX_MX25L2005",	0xC22012,	/* Same as MX25L2005C, MX25L2006E */
"MACRONIX_MX25L4005",	0xC22013,	/* Same as MX25L4005A, MX25L4005C, MX25L4006E */
"MACRONIX_MX25L8005",	0xC22014,	/* Same as MX25V8005, MX25L8006E, MX25L8008E, FIXME: MX25L8073E (4k 0x20) */
"MACRONIX_MX25L1605",	0xC22015,	/* MX25L1605 (64k 0x20); MX25L1605A/MX25L1606E/MX25L1608E (4k 0x20, 64k 0x52); MX25L1605D/MX25L1608D/MX25L1673E (4k 0x20) */
"MACRONIX_MX25L3205",	0xC22016,	/* MX25L3205, MX25L3205A (64k 0x20); MX25L3205D/MX25L3208D (4k 0x20); MX25L3206E/MX25L3208E (4k 0x20, 64k 0x52); MX25L3273E (4k 0x20, 32k 0x52) */
"MACRONIX_MX25L6405",	0xC22017,	/* MX25L6405, MX25L6405D (64k 0x20); MX25L6406E/MX25L6408E (4k 0x20); MX25L6436E/MX25L6445E/MX25L6465E/MX25L6473E (4k 0x20, 32k 0x52) */
"MACRONIX_MX25L12805",	0xC22018,	/* MX25L12805 */
"MACRONIX_MX25L12805D",	0xC22018,	/* MX25L12805D (no 32k); MX25L12865E, MX25L12835F, MX25L12845E (32k 0x52) */
"MACRONIX_MX25L25635F",	0xC22019,	/* Same as MX25L25639F, but the latter seems to not support REMS */
"MACRONIX_MX25L1635D",	0xC22415,
"MACRONIX_MX25L1635E",	0xC22515,	/* MX25L1635{E} */
"MACRONIX_MX66L51235F",	0xC2201a,	/* MX66L51235F */
"MACRONIX_MX25U8032E",	0xC22534,
"MACRONIX_MX25U1635E",	0xC22535,
"MACRONIX_MX25U3235E",	0xC22536,	/* Same as MX25U6435F */
"MACRONIX_MX25U6435E",	0xC22537,	/* Same as MX25U6435F */
"MACRONIX_MX25U12835E",	0xC22538,	/* Same as MX25U12835F */
"MACRONIX_MX25U25635F",	0xC22539,
"MACRONIX_MX25U51245G",	0xC2253a,
"MACRONIX_MX25L3235D",	0xC25E16,	/* MX25L3225D/MX25L3235D/MX25L3237D */
"MACRONIX_MX25L6495F",	0xC29517,
"MACRONIX_MX25R3235F",	0xC22816,
"MACRONIX_MX25R6435F",	0xC22817,

"NANTRONICS_N25S10",0xD53011,
"NANTRONICS_N25S20",0xD53012,
"NANTRONICS_N25S40",0xD53013,
"NANTRONICS_N25S80",0xD53014,
"NANTRONICS_N25S16",0xD53015,

"SANYO_LE25FW203A",	0x621600,
"SANYO_LE25FW403A",	0x621100,
"SANYO_LE25FU206A",	0x620612,
"SANYO_LE25FU406C",	0x620613,	/* Also known as LE25U40CMC apparently */

"SPANSION_S25FL004A",	0x010212,
"SPANSION_S25FL008A",	0x010213,
"SPANSION_S25FL016A",	0x010214,
"SPANSION_S25FL032A",	0x010215,	/* Same as S25FL032P, but the latter supports EDI and CFI */
"SPANSION_S25FL064A",	0x010216,	/* Same as S25FL064P, but the latter supports EDI and CFI */
"SPANSION_S25FL128",	0x012018,	/* Same ID for various S25FL127S, S25FL128P, S25FL128S and S25FL129P (including dual-die S70FL256P) variants (EDI supported) */
"SPANSION_S25FL256",	0x010219,
"SPANSION_S25FL512",	0x010220,
"SPANSION_S25FL204",	0x014013,
"SPANSION_S25FL208",	0x014014,
"SPANSION_S25FL216",	0x014015,	/* Same as S25FL216K, but the latter supports OTP, 3 status regs, quad I/O, SFDP etc. */
"SPANSION_S25FL116K",	0x014015,
"SPANSION_S25FL132K",	0x014016,
"SPANSION_S25FL164K",	0x014017,

"SST_SST25WF512",0xBF2501,
"SST_SST25WF010",0xBF2502,
"SST_SST25WF020",0xBF2503,
"SST_SST25WF040",0xBF2504,
"SST_SST25WF080",0xBF2505,
"SST_SST25WF020A",0xBF1612,
"SST_SST25WF040B",0xBF1613,
"SST_SST25WF080B",0xBF1614,
"SST_SST25VF020B",0xBF258C,
"SST_SST25VF040B",0xBF258D,
"SST_SST25VF080B",0xBF258E,
"SST_SST25VF016B",0xBF2541,
"SST_SST25VF032B",0xBF254A,
"SST_SST25VF064C",0xBF254B,

"ST_M25P05A",0x202010,
"ST_M25P10A",0x202011,
"ST_M25P20",0x202012,
"ST_M25P40",0x202013,
"ST_M25P80",0x202014,
"ST_M25P16",0x202015,
"ST_M25P32",0x202016,
"ST_M25P64",0x202017,
"ST_M25P128",0x202018,
"ST_M45PE10",0x204011,
"ST_M45PE20",0x204012,
"ST_M45PE40",0x204013,
"ST_M45PE80",0x204014,
"ST_M45PE16",0x204015,
"ST_M25PX80",0x207114,
"ST_M25PX16",0x207115,
"ST_M25PX32",0x207116,
"ST_M25PX64",0x207117,
"ST_M25PE10",0x208011,
"ST_M25PE20",0x208012,
"ST_M25PE40",0x208013,
"ST_M25PE80",0x208014,
"ST_M25PE16",0x208015,
"ST_N25Q016__1E",0x20BB15,	/* N25Q016, 1.8V, (uniform sectors expected) */
"ST_N25Q032__3E",0x20BA16,	/* N25Q032, 3.0V, (uniform sectors expected) */
"ST_N25Q032__1E",0x20BB16,	/* N25Q032, 1.8V, (uniform sectors expected) */
"ST_N25Q064__3E",0x20BA17,	/* N25Q064, 3.0V, (uniform sectors expected) */
"ST_N25Q064__1E",0x20BB17,	/* N25Q064, 1.8V, (uniform sectors expected) */
"ST_N25Q512__3E",0x20BA20,	/* N25Q512, 3.0V, (uniform sectors expected) */
"ST_N25Q128__3E",0x20BA18,	/* N25Q128/MT25QL128, 3.0V, (uniform sectors expected) */
"ST_N25Q128__1E",0x20BB18,	/* N25Q128/MT25QU128, 1.8V, (uniform sectors expected) */
"ST_N25Q256__3E",0x20BA19,	/* N25Q256/MT25QL256, 3.0V, (uniform sectors expected) */
"ST_N25Q256__1E",0x20BB19,	/* N25Q256/MT25QU256, 1.8V, (uniform sectors expected) */
"ST_N25Q512__3G",0x20BA20,	/* N25Q512/MT25QL512, 3.0V, (uniform sectors expected) */
"ST_N25Q512__1G",0x20BB20,	/* N25Q512/MT25QU512, 1.8V, (uniform sectors expected) */
"ST_N25Q00A__3G",0x20BA21,	/* N25Q00A/MT25QL01G, 3.0V, (uniform sectors expected) */
"ST_N25Q00A__1G",0x20BB21,	/* N25Q00A/MT25QU01G, 1.8V, (uniform sectors expected) */
"ST_MT25QL02G",0x20BA22,	/* MT25QL02G, 3.0V, (uniform sectors expected) */
"ST_MT25QU02G",0x20BB22,	/* MT25QU02G, 1.8V, (uniform sectors expected) */

"WINBOND_NEX_W25P80",	0xEF2014,
"WINBOND_NEX_W25P16",	0xEF2015,
"WINBOND_NEX_W25P32",	0xEF2016,
"WINBOND_NEX_W25X05",	0xEF3010 ,/* W25X05CL */
"WINBOND_NEX_W25X10",	0xEF3011,
"WINBOND_NEX_W25X20",	0xEF3012,
"WINBOND_NEX_W25X40",	0xEF3013,
"WINBOND_NEX_W25X80",	0xEF3014,
"WINBOND_NEX_W25X16",	0xEF3015,
"WINBOND_NEX_W25X32",	0xEF3016,
"WINBOND_NEX_W25X64",	0xEF3017,
"WINBOND_NEX_W25Q40_V",	0xEF4013,	/* W25Q40BV; W25Q40BL (2.3-3.6V) */
"WINBOND_NEX_W25Q80_V",	0xEF4014,	/* W25Q80BV */
"WINBOND_NEX_W25Q16_V",	0xEF4015,	/* W25Q16CV; W25Q16DV */
"WINBOND_NEX_W25Q32_V",	0xEF4016,	/* W25Q32BV; W25Q32FV in SPI mode (default) */
"WINBOND_NEX_W25Q64_V",	0xEF4017,	/* W25Q64BV, W25Q64CV; W25Q64FV in SPI mode (default) */
"WINBOND_NEX_W25Q128_V",	0xEF4018,	/* W25Q128BV, W25Q128FV (SPI mode), W25Q128JV */
"WINBOND_NEX_W25Q256_V",	0xEF4019,	/* W25Q256FV or W25Q256JV_Q (QE=1) */
"WINBOND_NEX_W25Q512JV",	0xEF4020,	/* W25Q512JV */
"WINBOND_NEX_W25Q20_W",	0xEF5012,	/* W25Q20BW */
"WINBOND_NEX_W25Q40BW",	0xEF5013,	/* W25Q40BW */
"WINBOND_NEX_W25Q80BW",	0xEF5014,	/* W25Q80BW */
"WINBOND_NEX_W25Q40EW",	0xEF6013,	/* W25Q40EW */
"WINBOND_NEX_W25Q80EW",	0xEF6014,	/* W25Q80EW */
"WINBOND_NEX_W25Q16_W",	0xEF6015,	/* W25Q16DW */
"WINBOND_NEX_W25Q32_W",	0xEF6016,	/* W25Q32DW; W25Q32FV in QPI mode */
"WINBOND_NEX_W25Q64_W",	0xEF6017,	/* W25Q64DW; W25Q64FV in QPI mode */
"WINBOND_NEX_W25Q128_W",	0xEF6018,	/* Same as W25Q128FV (QPI mode), W25R128FV */
"WINBOND_NEX_W25Q128FW",	0xEF6018,	/* Same as W25Q128FV (QPI mode), W25R128FV */
"WINBOND_NEX_W25Q256_W",	0xEF6019,	/* W25Q256JW */
"WINBOND_NEX_W25Q128_V_M",	0xEF7018,	/* W25Q128JVSM */
"WINBOND_NEX_W25Q256JV_M",	0xEF7019,	/* W25Q256JV_M (QE=0) */
"WINBOND_NEX_W25Q32JW",	0xEF8016,
"WINBOND_NEX_W25Q64JW",	0xEF8017,
"WINBOND_NEX_W25Q128_DTR",	0xEF8018,	/* W25Q128JW_DTR */
"WINBOND_NEX_W25Q256_DTR",	0xEF8019,	/* W25Q256JW_DTR aka W25Q256256JW-IM */

"ZETTADEVICE_ZD25D20",     0xBA2012,
"ZETTADEVICE_ZD25D40",     0xBA2013,
"UNKNOWN",0xffffff
};

char *chipid(unsigned int id)
{
	int i;

	i=0; while(1) {
		if (flash_chips[i].id==0xffffff) return flash_chips[i].name;
		if (flash_chips[i].id==id) return flash_chips[i].name;
		i++;
	}

}
