medpar/TP1/(commit log)

2025-09-19 Diagrama Gantt creado
    [TP1_Template.pdsprj]
2025-09-19 Nombre fichero proyecto actualizado
    [TP1_G1.pdsprj, TP1_Template.pdsprj]
2025-09-23 Avances en PCB1 y PCB2
    [TP1_G1.pdsprj]
2025-09-23 actulizado control de cambios
2025-09-24 Avances esquematico PCB1
    [TP1_G1.pdsprj]
2025-09-26 Esquemáticos PCB1 (Mario) y PCB2 (Miguel) acabados
    [TP1_G1.pdsprj]
2025-09-26 Layout PCBs 1 y 2 añadidos
    [TP1_G1.pdsprj]
2025-09-26 subido word de seguimiento
2025-09-26 Esquemático PCB3 (Víctor) incorporado
    [TP1_G1.pdsprj]
2025-09-27 Actualización del archivo TP1_G1
    [TP1_G1.pdsprj]
2025-09-27 Netlist errors corregidos
    [TP1_G1.pdsprj]
2025-09-28 actualizados los controles de cambio
2025-09-28 actualizados el seguimiento, falta añadir horas
2025-09-30 PCB0, PCB1 huellas colocadas
    [TP1_G1.pdsprj]
2025-10-03 PCB0, PCB1 huellas
    [TP1_G1.pdsprj]
2025-10-03 Subida de ficheros gantt, pert, bom3
2025-10-03 actualizado el diagrama de gantt
2025-10-03 Adición del BOM0 rn la carpeta Planificación
2025-10-04 actualizado general de BOM y añadido documentacion final
    [BOM_C_R.xlsx, TP1_G1 [20251003, 19-44-14].pdsprj, TP1_G1 [20251003, 19-48-52].pdsprj, TP1_G1 [20251003, 19-48-53].pdsprj, TP1_G1 [20251003, 19-48-54].pdsprj, TP1_G1 [20251003, 19-48-55].pdsprj, TP1_G1.pdsprj]
2025-10-04 añadido BOM1
    [BOM_C_R.xlsx, TP1_G1.pdsprj]
2025-10-07 actualizado excel bom
    [BOM_C_R.xlsx]
2025-10-07 07/10 PCBs
    [TP1_G1.pdsprj]
2025-10-07 Actualizado anexo de BOM
2025-10-07 actualización de anexos de la nueva antena
2025-10-07 actualizacion de word con nueva antena
2025-10-10 Add files via upload
    cambios pequeños en la estructura
2025-10-10 Add files via upload
    esquema del análisis eléctrico y térmico
    [Analisiselectrico.xlsx]
2025-10-10 Add files via upload
    esquema del analisis electrico y térmico
    [Analisiselectrico.xlsx]
2025-10-10 10/10 todas las PCBs acabadas
    [TP1_G1.pdsprj]
2025-10-10 Entrega semana 4
    [TP1_G1.pdsprj]
2025-10-10 actualizada la antena en esquemaicos es capturas
2025-10-14 actualizados control de cambios
2025-10-14 actualizado word de planificacion
2025-10-14 actualizado pdf de planificacion
2025-10-14 Add files via upload
    PCBs 0,2 y 3 completados con las guías.
    [TP1_G1 [20251007, 10-53-13].pdsprj, TP1_G1 [20251007, 10-53-14].pdsprj, TP1_G1 [20251014, 09-21-55].pdsprj, TP1_G1 [20251014, 09-28-44].pdsprj, TP1_G1 [20251014, 09-50-01].pdsprj, TP1_G1 [20251014, 09-50-03].pdsprj, TP1_G1 [20251014, 10-17-57].pdsprj, TP1_G1 [20251014, 10-21-16].pdsprj]
2025-10-14 Add files via upload
    actualización del análisis eléctrico
    [Analisiselectrico.xlsx]
2025-10-17 PCBs con planos de tierra finalizadas
    [TP1_G1.pdsprj, TP1_G1_2.pdsprj]
2025-10-17 Add files via upload
    Modificaciones de los esquematicos
    [TP1_G1.pdsprj]
2025-10-17 Add files via upload
    VERSION ANALISIS ELECTRICO
    [Analisiselectrico-C.xlsx]
2025-10-17 Subida viernes 17
    [Analisiselectrico-C.xlsx, Analisiselectrico.xlsx, TP1_G1.pdsprj]
2025-10-17 actualizado control de cambios
2025-10-19 añadido algunos analisis electricos
    [Analisiselectrico-C.xlsx]
2025-10-21 Errores arreglados
    [TP1_G1 [20251014, 09-50-03].pdsprj, TP1_G1 [20251014, 10-17-57].pdsprj, TP1_G1 [20251014, 10-21-16].pdsprj, TP1_G1 [20251014, 10-21-46].pdsprj, TP1_G1 [20251014, 10-21-55].pdsprj, TP1_G1.pdsprj]
2025-10-21 Add files via upload
    actualización inicio analisis térmico
    [Analisiselectrico-C.xlsx]
2025-10-23 Add files via upload
    análisis eléctrico y térmico "final"
    [Analisiselectrico-C.xlsx]
2025-10-23 actualizado ficheros
    [Analisiselectrico-C.xlsx, TP1_G1.pdsprj]
2025-10-24 PDFs de las PCBs exportados y ficheros Gerber creados
    [TP1_G1.pdsprj]
2025-10-24 analisis electrico
    [Analisiselectrico-C.xlsx]
2025-10-24 Add files via upload
    fichero de planificacion word añadido
2025-10-28 Plano de tierra antena corregido, pistas voltaje mas anchas, cosido en la PCB de la antena
    [TP1_G1.pdsprj]
2025-10-28 subido electr-termi
    [Analisiselectrico-C.xlsx]
2025-12-09 Add files via upload
    Ficheros LarVA modificados y ficheros de test -Clara y Miguel
2025-12-09 Add files via upload
    LarVa modificado y fichero de test -Clara y Miguel
2025-12-19 sensor bme
2026-01-13 Sensores creados
2026-01-13 Prueba de campo
2026-01-13 Spi y modulo lora creado
2026-01-19 añadido gantt y control de cambios
2026-02-02 subidos control de cambios finales¿?
2026-02-02 subidos control de cambios mas completos
2026-02-03 saco la carpeta software final
2026-02-03 Fix signos temperatura
2026-02-04 Timer corregido
2026-02-04 Capturas para memoria
2026-02-04 capturas sotware para memoria
